FredM67/PVRouter-3-phase/schematics/Readme.md

This directory contains schematics of 3-phase router circuits.
