FredM67/PVRouter-3-phase/3-phases/README.md

# Mk2PVRouter

My version of the 3-phase Mk2PVRouter firmware (see <http://www.mk2pvrouter.co.uk>)

Robin Emley already proposes a 3 phase PV-router (<https://www.mk2pvrouter.co.uk/3-phase-version.html>).
It supports 3 resistive output loads, which are completely independent.

## Implementation documentation

You can start reading the documentation here [3-phase diverter](https://fredm67.github.io/Mk2PVRouter/html/index.html).

## End-user documentation

### Overview

Goal was to modify/optimize the sketch for the "special" case of a 3-phase water heater. A 3-phase water heater is composed in fact of 3 independent heating elements. Most of the time, such a heater can be connected in mono, or 3-phase WYE or 3-phase Delta.
When connected in WYE (without varistor), there's no need of a neutral wire because the system is equally distributed, so at any time, there's no current flowing to the neutral.

If a diverter is used, the neutral wire must be connected.

Added functionalities:

- load priorities management (configurable)
- off-peak period detection (configurable)
- force full power
- temperature sensor (just reading for the moment)
- optimized (RF) data logging
- serial output in JSON or TXT

The original sketch had to be completely re-worked and re-structured to support temperature reading. In the original sketch, the ISR "just" reads and converts the analog data, and the processing is done in the loop. This won't work with a temperature sensor because of its slow performance. It would break the whole system, current/voltage data will be lost, ...

Now, all the time-critical processing is done inside the ISR, other stuff like (RF) data logging, Serial printing, temperature reading is made inside the loop(). The ISR and main processor communicate with each other through "events".

### Load priorities management

In my variant of Robin's sketch, the 3 loads are still physically independent, so it means, the router will divert surplus of energy to the first load (highest priority) from 0% to 100%, then to the second (0% to 100%) and finally to the third.

To avoid that the priorities stays all the time unchanged, which would mean that load 1 will run much more than load 2, which again will run much more than 3, I've added a priority management.
Each day, the load priorities are rotated, so over many days, all the heating elements will run somehow the same amount of time.

### Off-peak period detection

Depending on the country, some energy meters provide a switch which toggles on at the beginning of the off-peak period. It is intended to control a relay. If you wire it to a free digital pin of the router (in my case D3), you can detect off-peak/peak period.

### Force full power

Support has been added to force full power on specific loads. Each load can be forced independantly from each other, start time and duration can be set individualy.

In my variant, that's used to switch the heater one during off-peak period if not enough surplus has been routed during the day. Here, to optimize the behavior, a temp-sensor will be used to check the temperature of the water and decide to switch on or not during night.

### Temperature sensor

For the moment, just reading. It'll be used to optimize force full power, to make the right decision during night.

### Wiring diagram

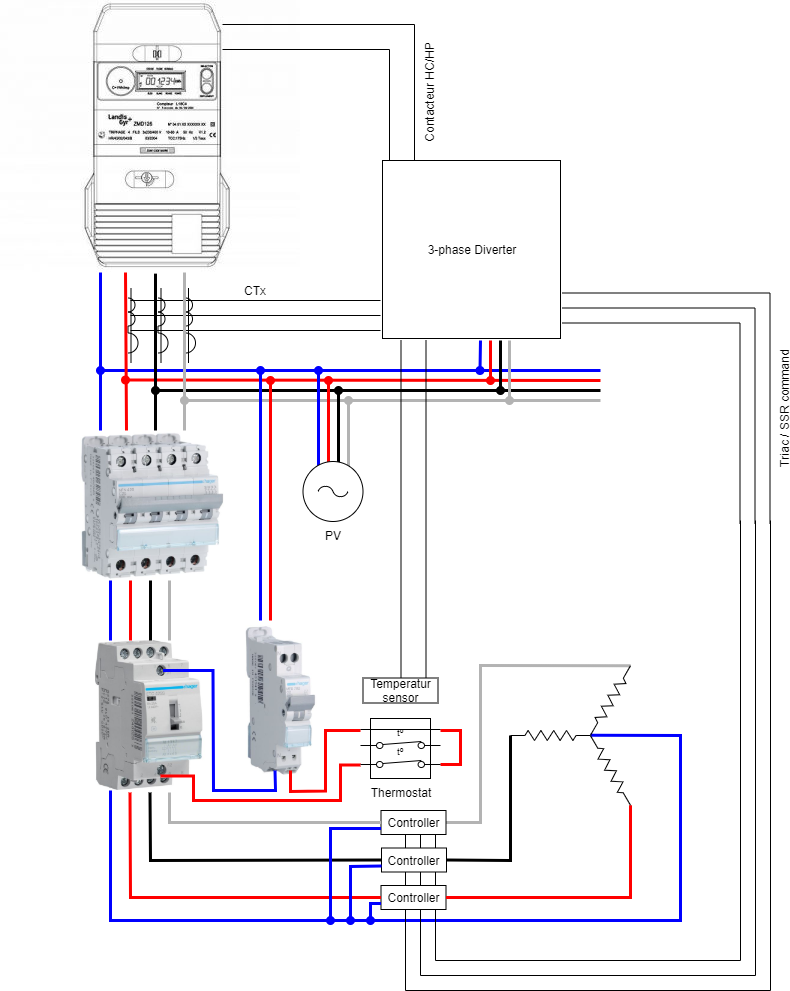
[picture p9: 3-phases/Chauffe-eau.png]
Chauffe-eau

*Figure: Wiring diagram*

#### About the thermostat

Since on all (3-phase) water heaters I've seen, the thermostat switches only 2 phases in normal mode (all 3 phases in security mode), it must be wired in another way to achieve a full switch on all 3 phases. In a fully balanced 3-phase situation, you don't need any neutral wire. To switch off the device, you only need to switch off 2 phases.

For that, I've "recycled" a peak/off peak 3-phase relay. It doesn't matter on which phase the command coil is connected, but it must be permanent (not through the router).
