FredM67/PVRouter-3-phase/dev/cal_CTx_v_meter/Readme.md

# Mk2PVRouter (calibration)

Calibration sketch for the 3-phase router.
