FredM67/PVRouter-3-phase/lang/en-us/Gallery.md

# Photo Gallery (3-phase version)

A couple of my realizations... other coming...

## 3-phase router with 3 outputs

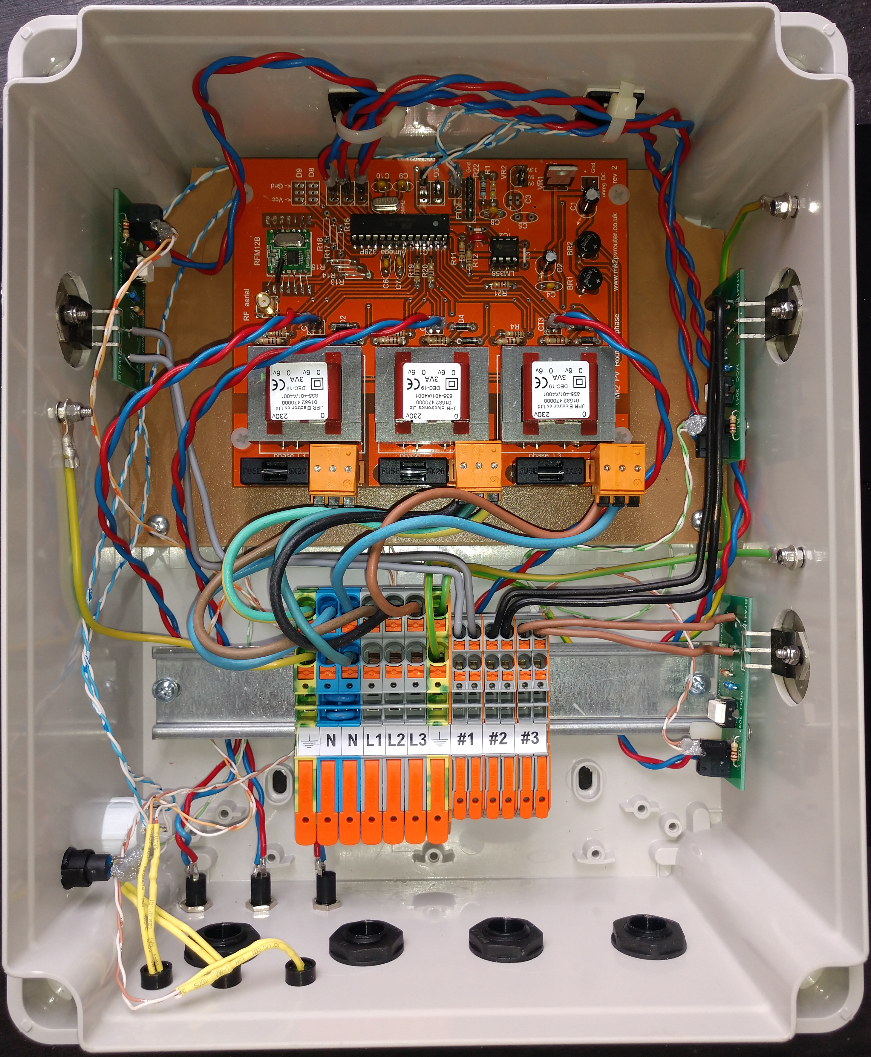
[picture p10: img/f43a4829-44de-41a0-b174-76a6b04aa8e5.jpg]
[](../../img/f43a4829-44de-41a0-b174-76a6b04aa8e5.jpg "Global view")

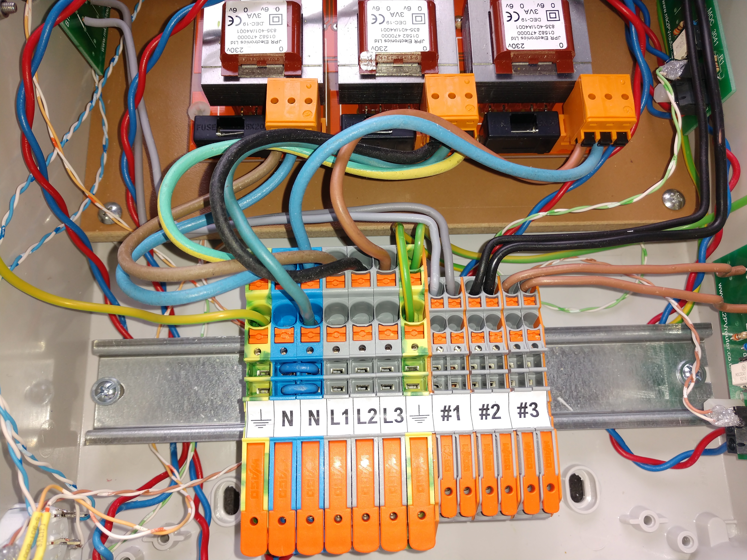
[picture p11: img/15fbcad6-1bfa-4044-9d88-a480483ec13e.jpg]
Rail terminal blocks
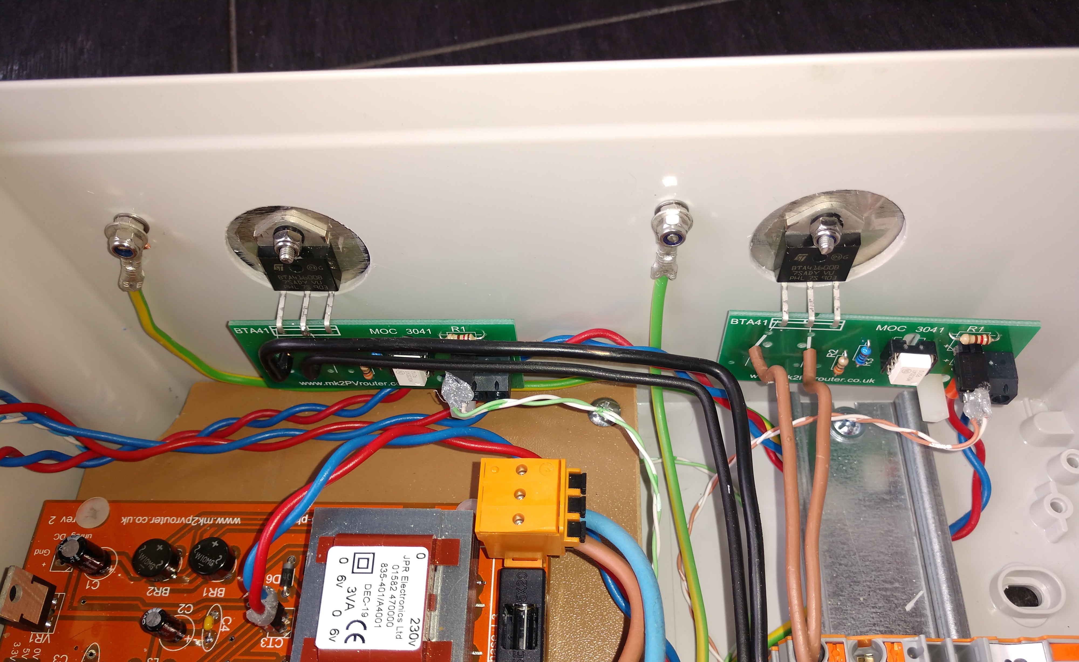
[picture p12: img/5dacd511-de53-4113-8b8e-37a5f743554b.jpg]
Mounted outputs
Detailed view of an output
[](../../img/15fbcad6-1bfa-4044-9d88-a480483ec13e.jpg "Rail terminal blocks") [](../../img/5dacd511-de53-4113-8b8e-37a5f743554b.jpg "Mounted outputs") [](../../img/66680b82-261f-409e-a767-3690944cae35.jpg "Detailed view of an output")

## 3-phase router with 4 outputs

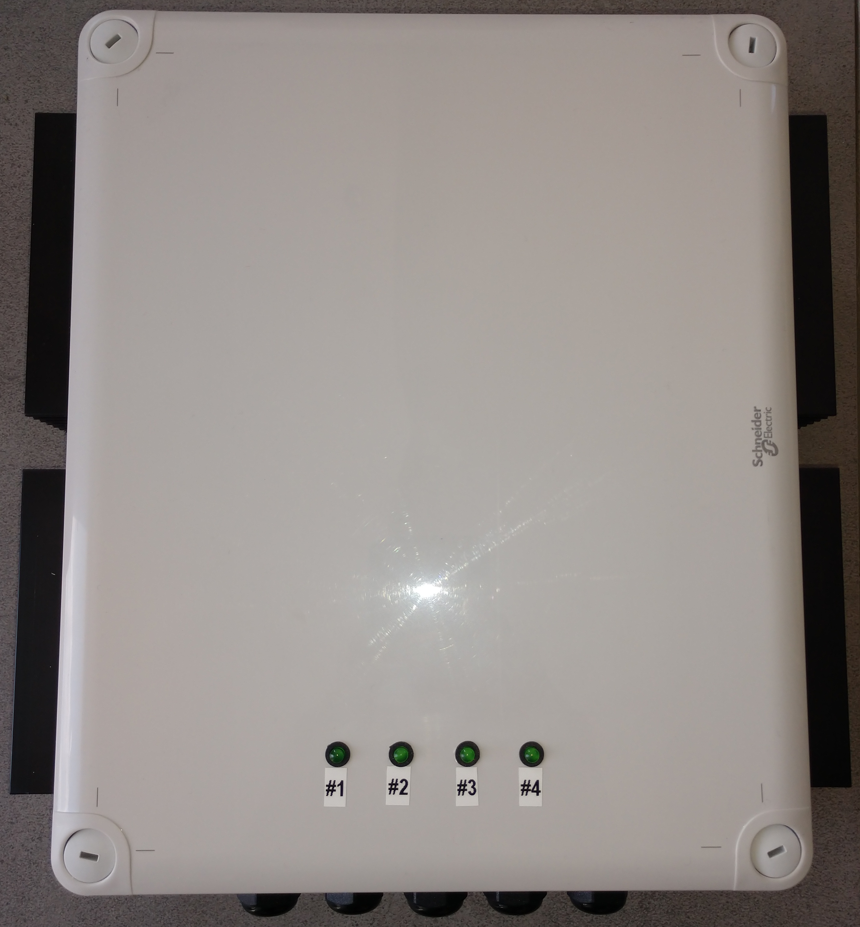
[picture p14: img/f05c2b09-0ed7-457f-b3fd-c86048cb763e.jpg]
[](../../img/f05c2b09-0ed7-457f-b3fd-c86048cb763e.jpg "Global view")

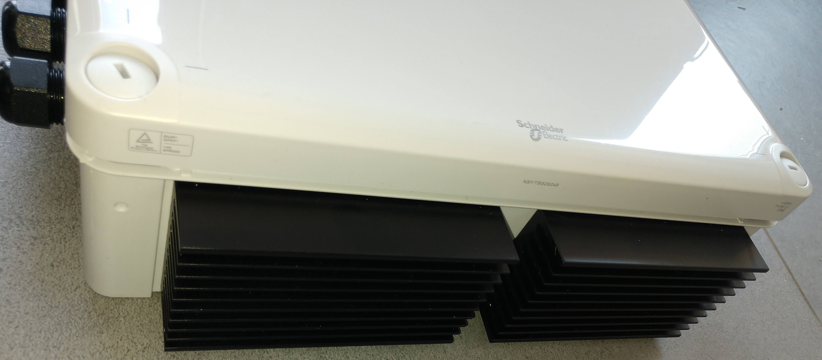
[picture p15: img/ada72e61-2f97-41ee-8d40-62b1563c619a.jpg]
Heatsinks
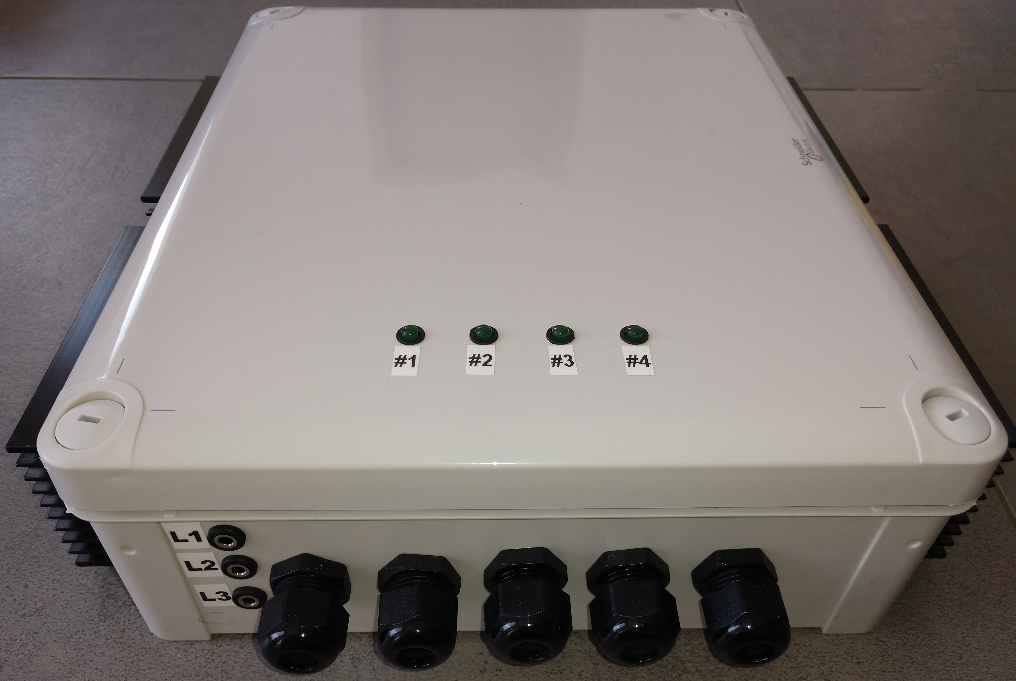
[picture p16: img/897cdbe2-732a-4d81-9d10-05e575900748.jpg]
External connections
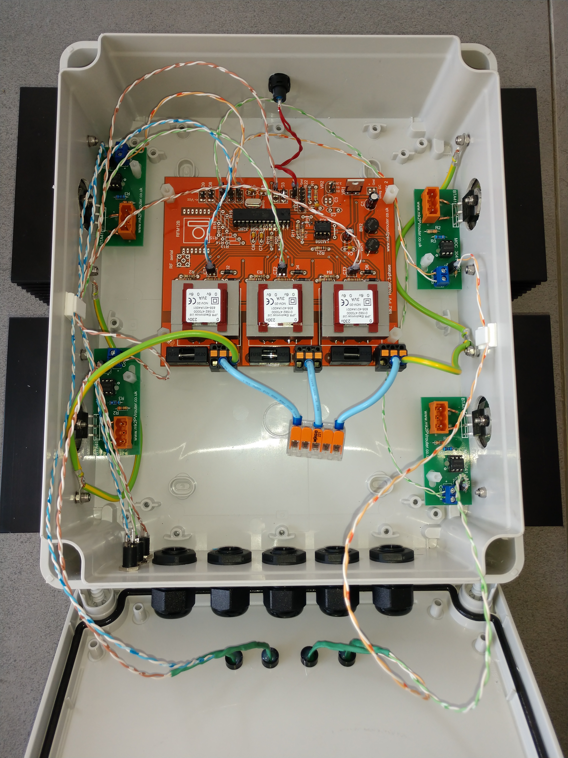
[picture p17: img/8c1568f4-78a3-4125-9e14-d849fb266f01.jpg]
[](../../img/ada72e61-2f97-41ee-8d40-62b1563c619a.jpg "Heatsinks") [](../../img/897cdbe2-732a-4d81-9d10-05e575900748.jpg "External connections") [](../../img/8c1568f4-78a3-4125-9e14-d849fb266f01.jpg "Inside the enclosure")

## 3-phase router, 4 remote cable-wired outputs (optionally 6), all outputs wired through network-cable, split box

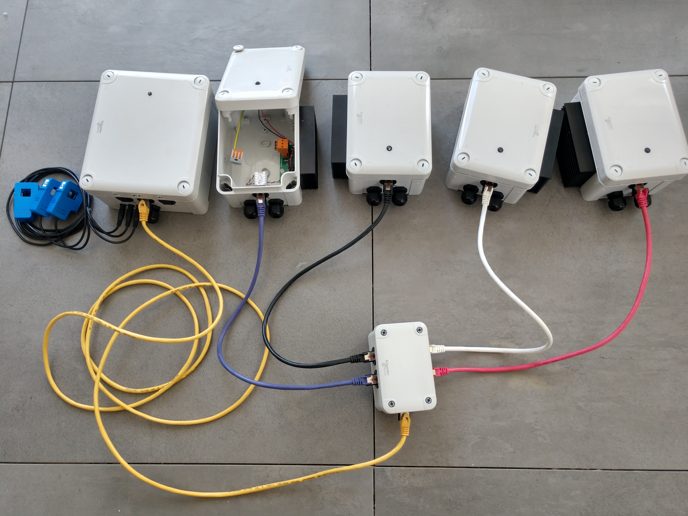
[picture p18: img/d03d563a-dc9d-4a5e-b4b6-94b93cb05c39.jpg]
[](../../img/d03d563a-dc9d-4a5e-b4b6-94b93cb05c39.jpg "Global view")

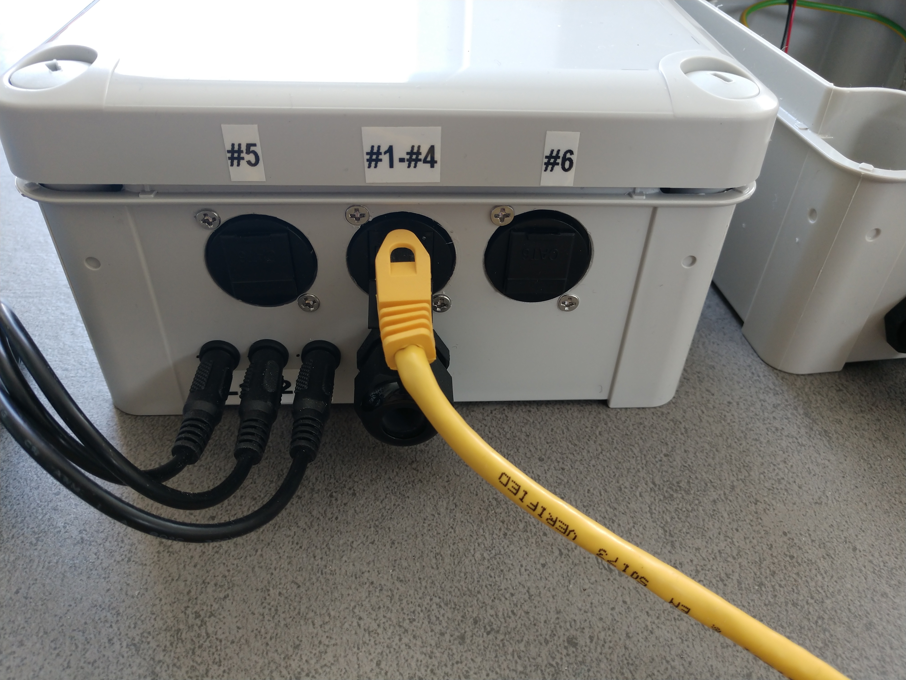
[picture p19: img/d395ef4b-2886-42bc-bf0d-46881865aba8.jpg]
In/Outputs on the main enclosure
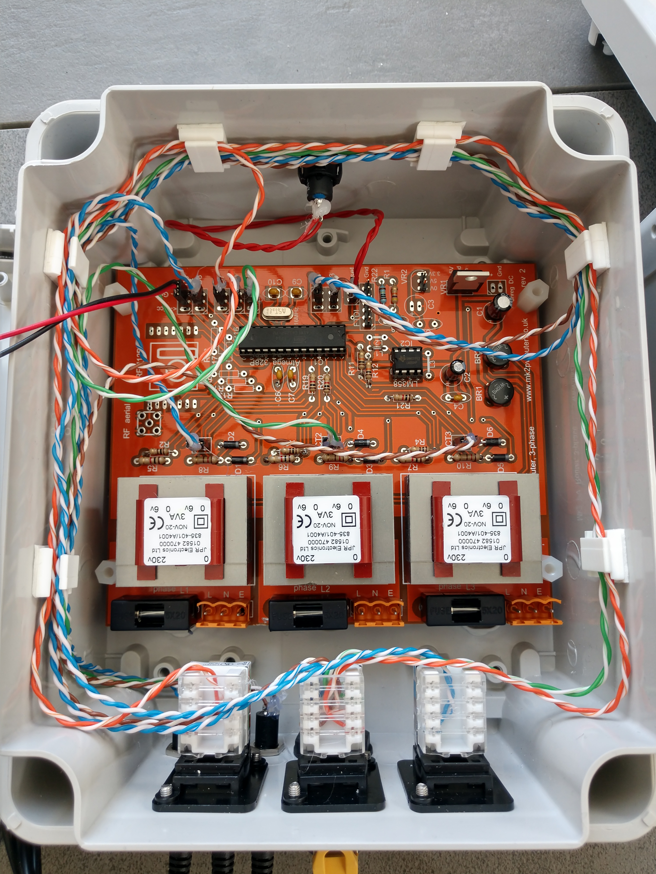
[picture p20: img/b5a37129-8ef5-4b52-9db6-86991e1d2f7e.jpg]
Inside the main enclosure
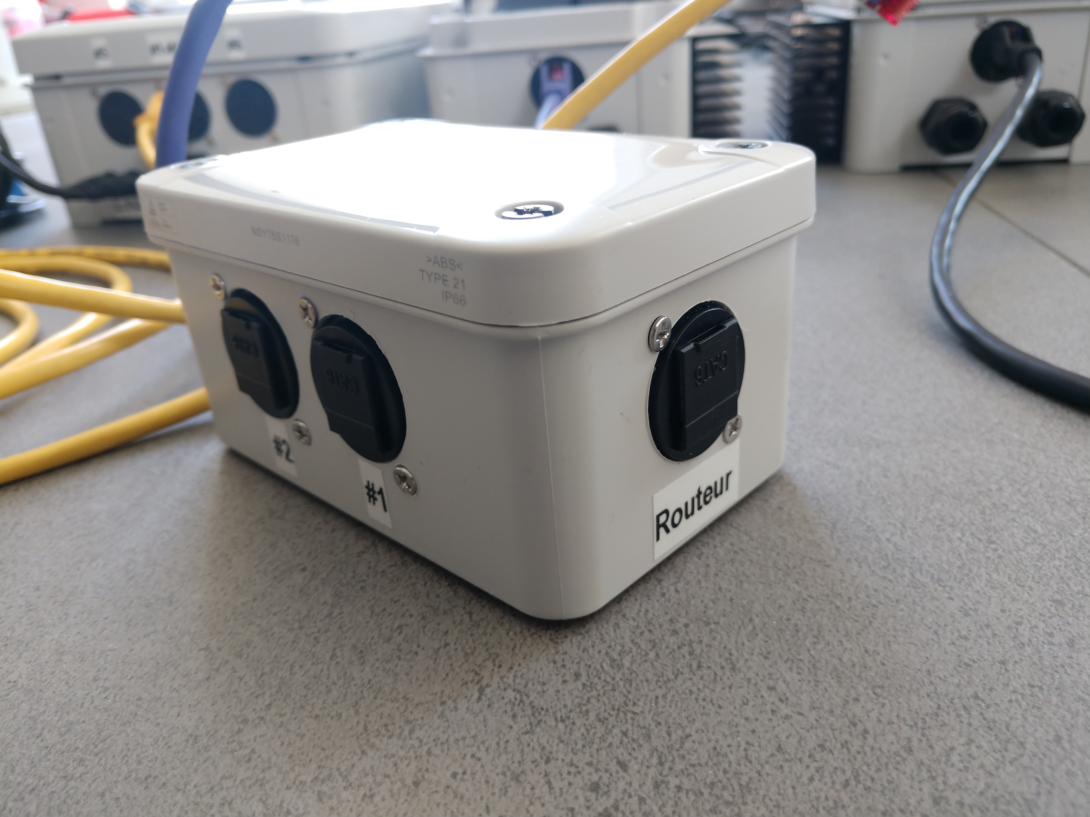
[picture p21: img/3e970a16-3d55-4a36-852a-2b2628096997.jpg]
The split box
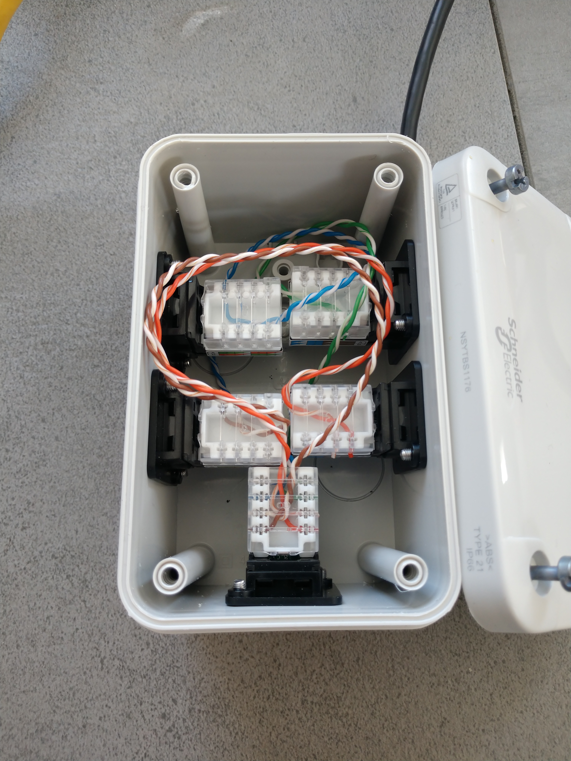
[picture p22: img/4e9bc2a4-d0be-4040-9475-e14ed643a81f.jpg]
Inside the split box
[](../../img/d395ef4b-2886-42bc-bf0d-46881865aba8.jpg "In/Outputs on the main enclosure") [](../../img/b5a37129-8ef5-4b52-9db6-86991e1d2f7e.jpg "Inside the main enclosure") [](../../img/3e970a16-3d55-4a36-852a-2b2628096997.jpg "The split box") [](../../img/4e9bc2a4-d0be-4040-9475-e14ed643a81f.jpg "Inside the split box")

## 3-phase router, 3 outputs, 2 of them can be controlled via Internet (ON/OFF and forcing)

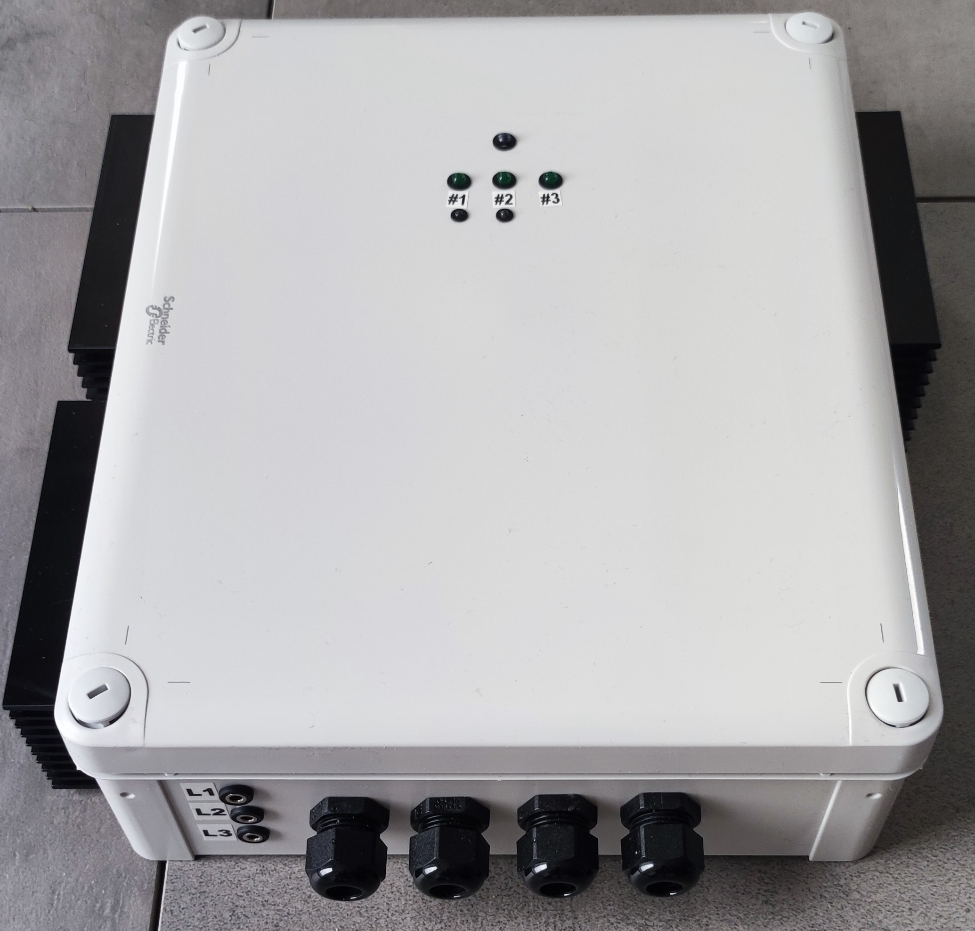
[picture p23: img/ef52c81c-a295-45f7-bca3-10eb83e562a4.jpg]
[](../../img/ef52c81c-a295-45f7-bca3-10eb83e562a4.jpg "Global view")

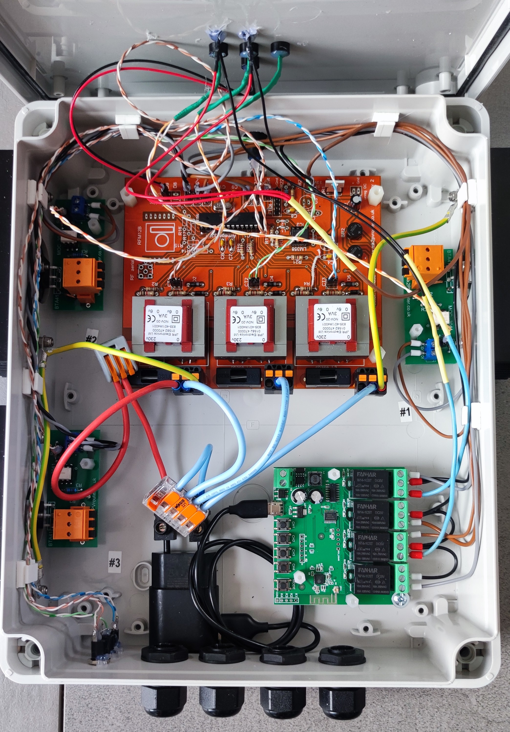
[picture p24: img/087771a1-7ec3-4b7a-a278-35999f6821ce.jpg]
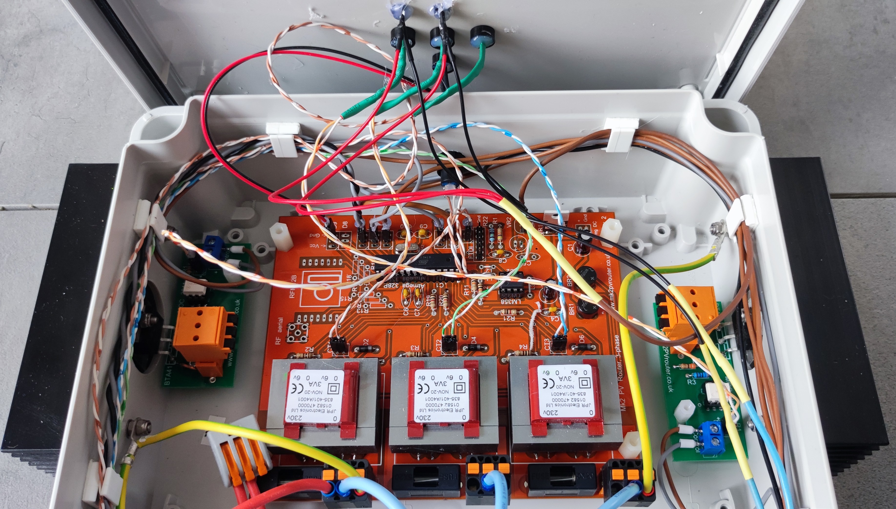
[picture p25: img/85be2be7-bddf-4039-a8d4-92ca197cbb45.jpg]
Router side
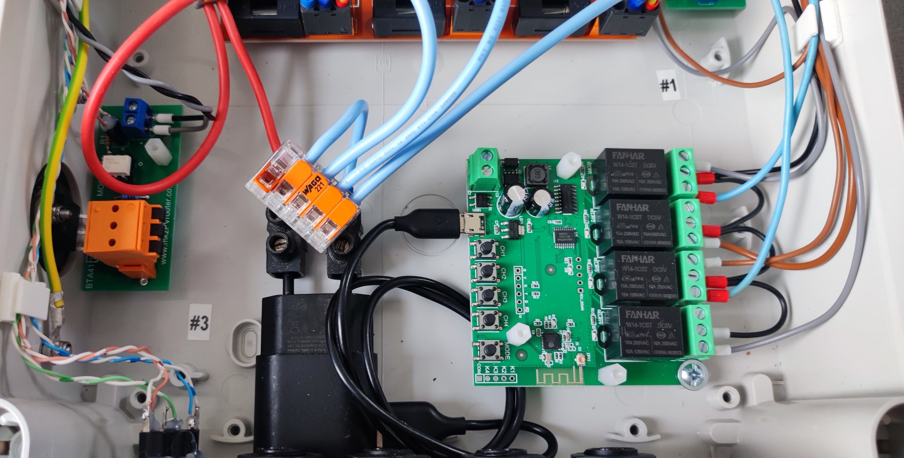
[picture p26: img/819f9d70-4cc6-4b29-9f21-2e0b1ef3fdeb.jpg]
Smart-Relay side
[](../../img/087771a1-7ec3-4b7a-a278-35999f6821ce.jpg "Inside the enclosure") [](../../img/85be2be7-bddf-4039-a8d4-92ca197cbb45.jpg "Router side") [](../../img/819f9d70-4cc6-4b29-9f21-2e0b1ef3fdeb.jpg "Smart-Relay side")

## 3-phase router, 6 outputs, all can be controlled via Internet (forcing and priority inversion)

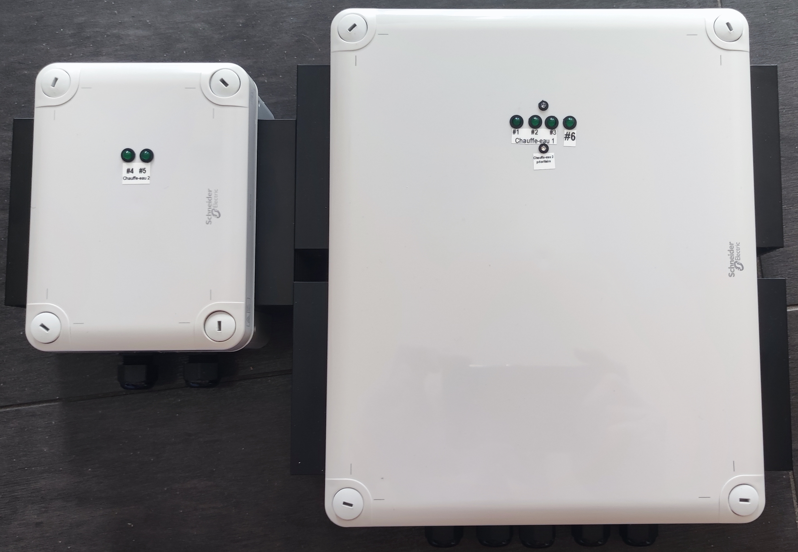
[picture p27: img/67a14e30-d1ed-40c5-9e4e-aacd2ed93499.jpg]
[](../../img/67a14e30-d1ed-40c5-9e4e-aacd2ed93499.jpg "Global view")

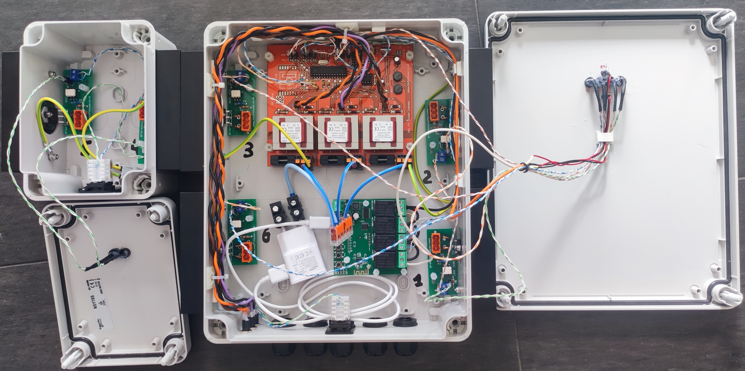
[picture p28: img/fec8f37e-e799-4abc-9041-8d9bfd7e70b1.jpg]
[](../../img/fec8f37e-e799-4abc-9041-8d9bfd7e70b1.jpg "Inside the enclosure")

## 3-phase router, 8 outputs, controlled as pair (1-5, 2-6, 3-7, 4-8), group overwrite (1-2-3, 4, 5-6-7, 8)

[Vue d'ensemble](../../img/e3771671-75ca-476e-a3ef-71582be48c67.jpg "Global view top")
[Vue d'ensemble](../../img/0f794432-89e2-4ba1-b937-163a495122d8.jpg "Global view connections")

[Inside the mainboard enclosure](../../img/6cbcf9fc-bbc0-4d99-a64a-3eaab45e34d8.jpg "Inside the mainboard enclosure") [Inside the slave enclosure](../../img/e903ec0d-7f42-4b21-998d-019408e88f20.jpg "Inside the slave enclosure") [Mainboard](../../img/20a99fa9-3dcc-4d16-a75c-3266c4db29ac.jpg "Mainboard") [Overwrite switches](../../img/aec80e39-caa6-495b-b781-55cd9dc704b2.jpg "Overwrite switches")
