FredM67/PVRouter-3-phase/docs/Carte-mère.pdf

# Alimentation du routeur triphasé

## Le routeur DOIT être installé de telle façon que les dissipateurs soient à droite et à gauche. (verticaux)

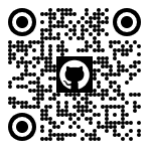
[picture p29: figure]

Selon l'arrivage et disponibilité, les borniers peuvent être différents (couleur, à vis, push-in, ...)

## Routeur - carte-mère

## N L1 L2 L3

L1 | L2 | L3

Il n'est pas strictement nécessaire d'alimenter le routeur via un disjoncteur tétrapolaire, étant donné que chaque entrée est déjà protégée par un fusible de 100mA.
Cependant, il est quand-même conseillé d'utiliser un disjoncteur/sectionneur tétrapolaire dédié.
Il fera aussi office d'interrupteur pour éteindre le routeur pendant une période d'absence par exemple.

## Installation des pinces

Les pinces doivent être installées entre le compteur/disjoncteur principal et l'arrivée principale dans le tableau.

Il y a une flèche gravée sur chaque pince. Cette flèche doit être dans le sens compteur VERS tableau.

Il faut respecter le marquage. La pince L1, doit être connectée à la prise jack L1.

La phase qui passe par la pince L1 doit être la même que celle qui est connectée à la borne L1 de l'alimentation du routeur. Idem pour L2 et L3.
Si nécessaire, contrôler au multimètre (position V~) :

tension entre phases différentes => env. 400V
tension sur la même phase => 0V.

Les borniers à vis, si présents, doivent être contrôlés au bout de quelques jours mais aussi régulièrement.
Au besoin resserrer les bornes. (sans forcer non plus)

L1
L2
L3
1 | 2 | 3
