FredM67/PVRouter-3-phase/README.md

<div align = center>


&nbsp; &nbsp;

<br/>
Stand With Ukraine (https://stand-with-ukraine.pp.ua)
</div>

<p align="center">
  <span>Français</span> |
  <a href="lang/en-us/">English</a>
</p>

# PVRouter (version triphasée)

Ma version du firmware Mk2PVRouter en 3 phases (voir http://www.mk2pvrouter.co.uk).

Robin Emley propose déjà un routeur PV triphasé (https://www.mk2pvrouter.co.uk/3-phase-version.html). Il prend en charge 3 charges de sortie résistives, qui sont complètement indépendantes.

---
**_NOTE:_** Pour une version en monophasé, voir [PVRouter-Single](https://github.com/FredM67/PVRouter-Single).

---

- [PVRouter (version triphasée)](#pvrouter-version-triphasée)
  - [Gallerie photo](#gallerie-photo)
  - [Schéma de la carte-mère](#schéma-de-la-carte-mère)
  - [Documentation de développement](#documentation-de-développement)
  - [Documentation de l’utilisateur final](#documentation-de-lutilisateur-final)
    - [Aperçu](#aperçu)
    - [Gestion des priorités de charge](#gestion-des-priorités-de-charge)
    - [Détection HC](#détection-hc)
    - [Forçage pleine puissance](#forçage-pleine-puissance)
    - [Capteur de température](#capteur-de-température)
    - [Profil Enphase zéro export](#profil-enphase-zéro-export)
- [Comment câbler le routeur](#comment-câbler-le-routeur)
- [Applications / Diagrammes de câblage](#applications--diagrammes-de-câblage)
  - [Pré-requis](#pré-requis)
  - [Chauffe-eau avec thermostat mécanique](#chauffe-eau-avec-thermostat-mécanique)
    - [Passage du monophasé au triphasé (avec neutre)](#passage-du-monophasé-au-triphasé-avec-neutre)
    - [Câblage](#câblage)
  - [Chauffe-eau avec thermostat ACI monophasé](#chauffe-eau-avec-thermostat-aci-monophasé)
  - [Chauffe-eau avec thermostat ACI triphasé (SANS neutre)](#chauffe-eau-avec-thermostat-aci-triphasé-sans-neutre)
  - [Alternatives SANS neutre](#alternatives-sans-neutre)
    - [Chauffe-eau avec thermostat mécanique](#chauffe-eau-avec-thermostat-mécanique-1)

## Gallerie photo

Vous trouverez quelques [photos](Gallery.md) de routeurs assemblés.

## Schéma de la carte-mère

Vous trouverez [ici](schematics/3phase_Mainboard.pdf) le schéma de la carte-mère.

## Documentation de développement

Vous pouvez commencer à lire la documentation ici [3-phase diverter](https://fredm67.github.io/PVRouter-3-phase/) (en anglais).

## Documentation de l’utilisateur final

### Aperçu

L’objectif était de modifier/optimiser le programme pour le cas « spécial » d’un chauffe-eau triphasé. Un chauffe-eau triphasé est composé en fait de 3 éléments de chauffage indépendants. La plupart du temps, un tel chauffe-eau peut être connecté en monophasé, en triphasé étoile (WYE) ou triphasé triangle (Delta). Lorsqu’il est connecté en étoile (sans varistor), il n’y a pas besoin de fil de neutre parce que le système est équilibré, donc à tout moment, il n’y a pas de courant qui circule vers le neutre.

Fonctionnalités ajoutées :

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

### Gestion des priorités de charge

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

### Détection HC

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

### Forçage pleine puissance

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

### Capteur de température

Pour l’instant, uniquement lecture. Il sera utilisé pour optimiser la pleine puissance de la force, pour prendre la bonne décision pendant la nuit.

### Profil Enphase zéro export

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

Comme effet secondaire, le diverteur ne verra pas à aucun moment un surplus d’énergie.  
L’idée est donc d’appliquer un certain décalage à l’énergie mesurée par le diverteur.
Comme il est déjà commenté dans le code, après l'assignation d’une valeur négative à *REQUIRED_EXPORT_IN_WATTS*, le diverter agira comme un générateur PV.  
Si vous définissez une valeur de *-20*, chaque fois que le diverter mesure le flux d’énergie, il ajoutera *-20* aux mesures.  

Alors, maintenant voyons ce qui se passe dans différents cas:

- la valeur mesurée est **positive** (importation d’énergie = pas d’excédent), après avoir ajouté *-20*, cela reste positif, le diverter ne fait rien. Pour une valeur comprise entre -20 et 0, le déviateur ne fera rien non plus.
- la valeur mesurée est **autour de zéro**. Dans cette situation, la limitation du "profil zéro exportation" est active.  
Après l’ajout de *-20*, nous obtenons une valeur négative, ce qui déclenchera le détournement d’énergie vers le chauffe-eau.  
Ensuite, il y a une sorte de réaction en chaîne. L’Envoy détecte plus de consommation, décide d’augmenter la production.  
À la mesure suivante, le diverter mesure à nouveau une valeur autour de zéro, ajoute à nouveau -20, et détourne encore plus d’énergie.  
Lorsque la production (et l’excédent) arrive au maximum possible, la valeur mesurée restera autour de zéro+ et le système deviendra stable.

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

# Applications / Diagrammes de câblage

Je veux:

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

## Pré-requis

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

---
**_Avertissement de sécurité_**

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

---

## Chauffe-eau avec thermostat mécanique

### Passage du monophasé au triphasé (avec neutre)

---
**_Nécessite un routeur avec 3 sorties_**

Avec cette solution, vous commandez chaque résistance séparément l'une de l'autre.

---

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

### Câblage

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

---
**_Rappel_**

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

---

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

Chauffe-eau avec thermostat mécanique  
*Figure: Diagramme de câblage*

## Chauffe-eau avec thermostat ACI monophasé

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

Chauffe-eau avec thermostat ACI monophasé  
*Figure : Diagramme de câblage*

## Chauffe-eau avec thermostat ACI triphasé (SANS neutre)

---
**_Nécessite un routeur avec 2 sorties_**

Avec cette solution, vous commandez chaque résistance séparément l'une de l'autre.

---

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

La carte ACI doit être reliée à 3 phases permanentes.

Chauffe-eau avec thermostat ACI triphasé  
*Figure : Diagramme de câblage*

## Alternatives SANS neutre

---
**_Nécessite un routeur avec 2 sorties_**

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

---

### Chauffe-eau avec thermostat mécanique

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

---
**_Zoom sur le thermostat_**

Il faut bien faire attention, en regardant sur le thermostat, quelles bornes sont coupées.

En **rouge**, coupure de sécurité (remarquez le 'S' sur chaque contact) : les 3 phases sont coupées.

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

Thermostat mécanique  
*Figure: Exemple de thermostat*

---

Chauffe-eau avec thermostat mécanique  
*Figure: Diagramme de câblage*
