FredM67/PVRouter-3-phase/Gallery.md

<h1>Galerie photo (version triphasée)</h1>

Quelques une de mes réalisations... d'autres à venir...

- [Routeur triphasé 3 sorties](#routeur-triphasé-3-sorties)
- [Routeur triphasé 4 sorties multi-boîtier (carte-mère, 3 sorties, 1 sortie)](#routeur-triphasé-4-sorties-multi-boîtier-carte-mère-3-sorties-1-sortie)
  - [Boîtier carte-mère](#boîtier-carte-mère)
  - [Boîtier 3 sorties à proximité du chauffe-eau](#boîtier-3-sorties-à-proximité-du-chauffe-eau)
  - [Boîtier 1 sortie déporté](#boîtier-1-sortie-déporté)
- [Routeur triphasé 4 sorties](#routeur-triphasé-4-sorties)
- [Routeur triphasé, 4 sorties distantes par câble (en option 6), sorties connectées par câble réseau, boîte de répartition](#routeur-triphasé-4-sorties-distantes-par-câble-en-option-6-sorties-connectées-par-câble-réseau-boîte-de-répartition)
- [Routeur triphasé, 3 sorties, dont 2 pilotables via Internet (ON/OFF et marche forcée)](#routeur-triphasé-3-sorties-dont-2-pilotables-via-internet-onoff-et-marche-forcée)
- [Routeur triphasé, 6 sorties, toutes pilotables via Internet (marche forcée et inversion de priorité)](#routeur-triphasé-6-sorties-toutes-pilotables-via-internet-marche-forcée-et-inversion-de-priorité)
- [Routeur triphasé, 8 sorties, pilotées par paire (1-5, 2-6, 3-7, 4-8), marche forcée par groupe (1-2-3, 4, 5-6-7, 8)](#routeur-triphasé-8-sorties-pilotées-par-paire-1-5-2-6-3-7-4-8-marche-forcée-par-groupe-1-2-3-4-5-6-7-8)
- [Routeur triphasé, 8 sorties, sorties 4 et 5 pilotées ensemble, 4 groupes de marche forcée (1-2-3, 4, 5, 6-7-8)](#routeur-triphasé-8-sorties-sorties-4-et-5-pilotées-ensemble-4-groupes-de-marche-forcée-1-2-3-4-5-6-7-8)

## Routeur triphasé 3 sorties

<p align="center">
Vue d'ensemble
<br>
Connecteurs sur rail
Montage des platines de sortie
Zoom sur une platine de sortie
</P>

## Routeur triphasé 4 sorties multi-boîtier (carte-mère, 3 sorties, 1 sortie)

### Boîtier carte-mère
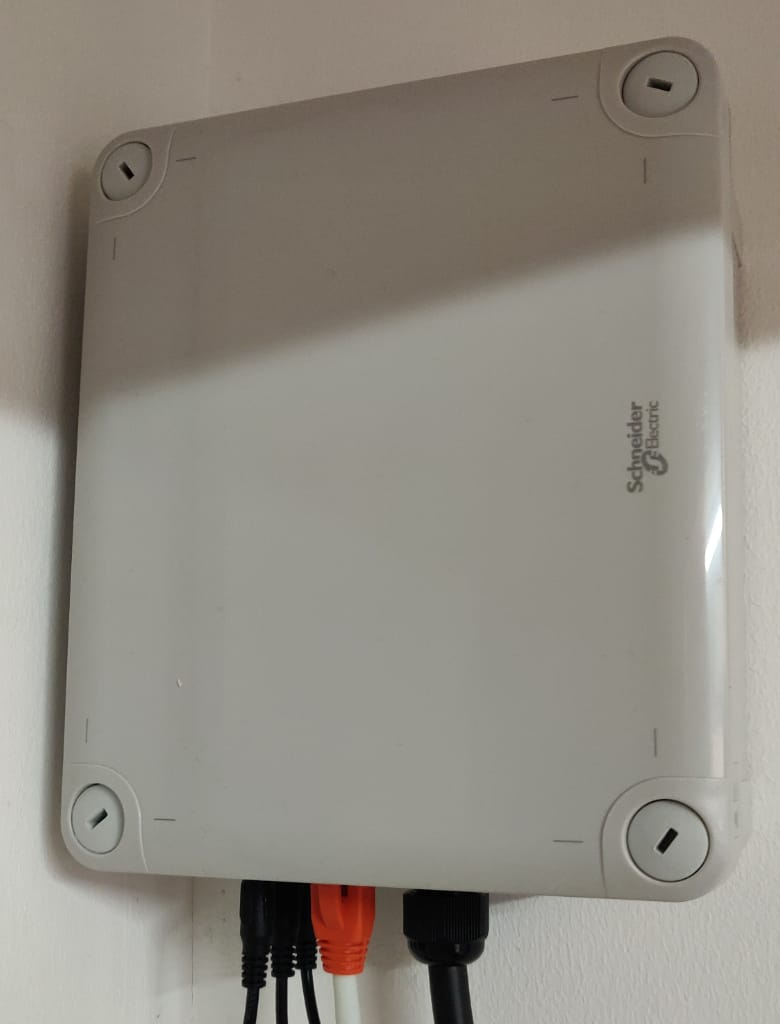
[picture p30: img/ce87c606-ab8e-44c3-b274-a3130b65f113.jpg]
Boîtier carte-mère
[](img/ce87c606-ab8e-44c3-b274-a3130b65f113.jpg "Boîtier carte-mère")
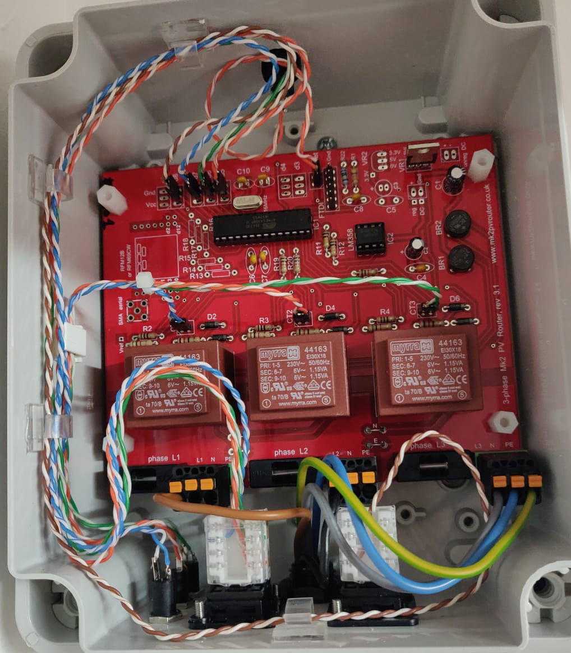
[picture p31: img/ad63052d-ebe5-4e1f-9275-3632a48a1255.jpg]
[](img/ad63052d-ebe5-4e1f-9275-3632a48a1255.jpg "Intérieur")

### Boîtier 3 sorties à proximité du chauffe-eau
Ce boîtier contient les 3 sorties mais aussi une horloge et un contacteur pour la marche forcée programmée.
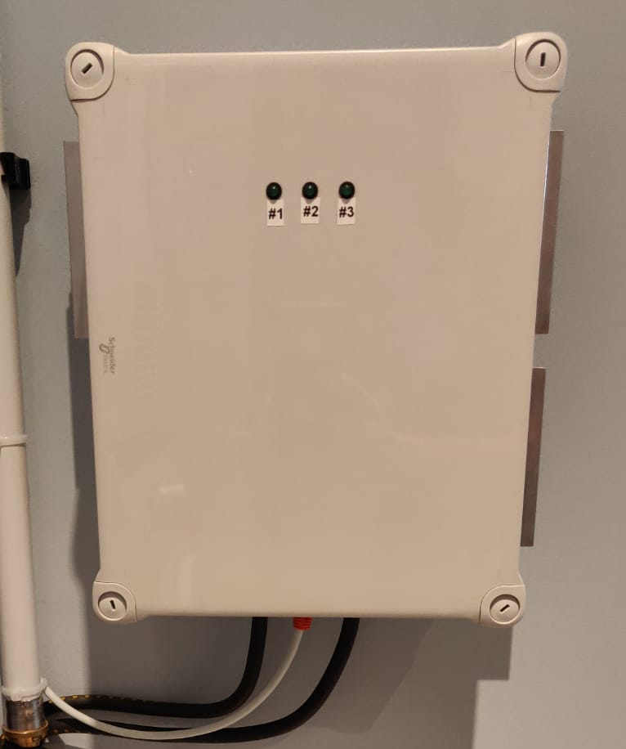
[picture p32: img/5291760f-7a21-42bc-bc12-00a551be847b.jpg]
Boîtier chauffe-eau
[](img/5291760f-7a21-42bc-bc12-00a551be847b.jpg "Boîtier chauffe-eau")

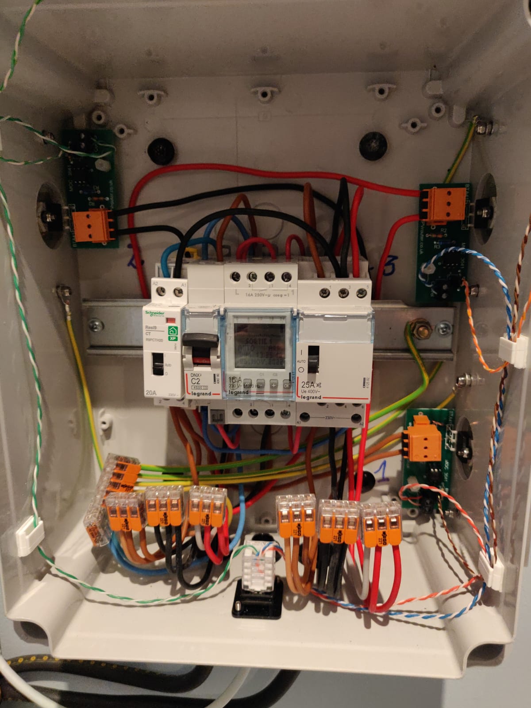
[picture p33: img/071abcd1-ac9d-46c5-bbe8-30d14bfc3ad4.jpg]
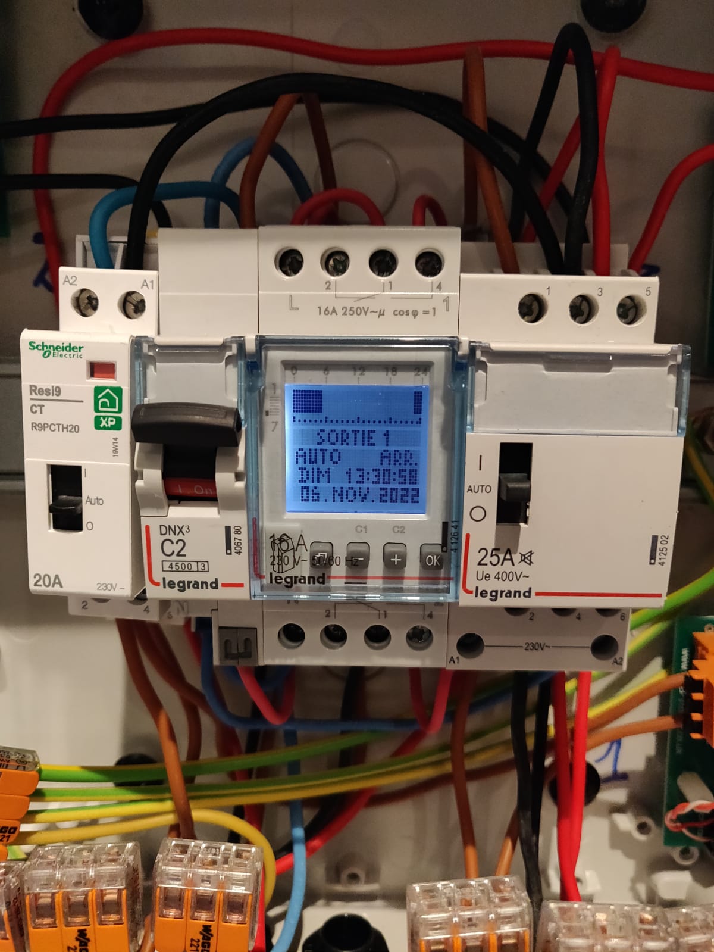
[picture p34: img/f40a586f-e764-486c-9dc7-2c0aa3767f4b.jpg]
Détail horloge/contacteur
[](img/071abcd1-ac9d-46c5-bbe8-30d14bfc3ad4.jpg "Intérieur") [](img/f40a586f-e764-486c-9dc7-2c0aa3767f4b.jpg "Détail horloge/contacteur")

### Boîtier 1 sortie déporté
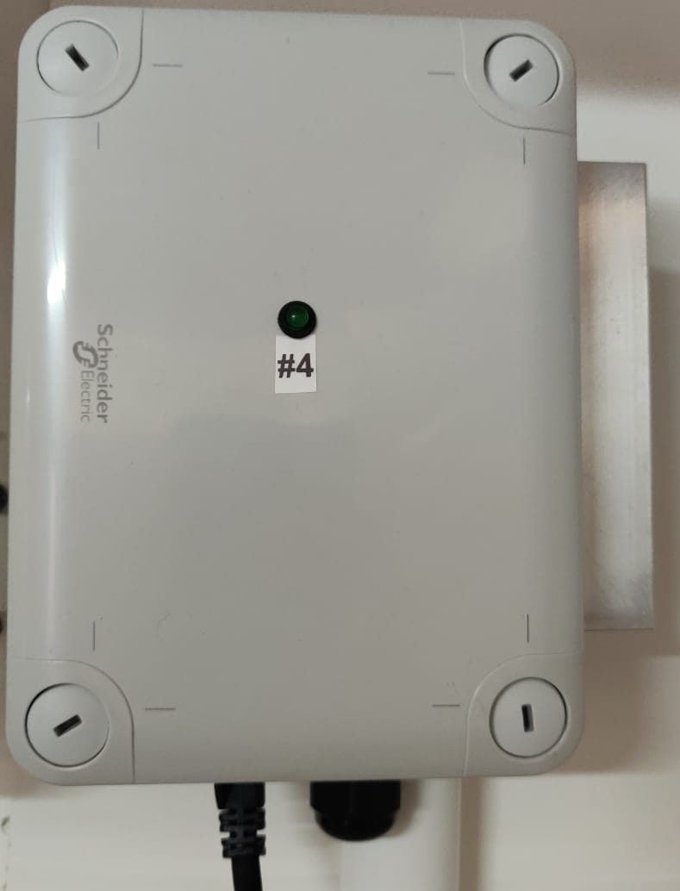
[picture p35: img/ed17d132-fba7-4b36-9564-83fd12fedd17.jpg]
Boîtier 1 sortie
[](img/ed17d132-fba7-4b36-9564-83fd12fedd17.jpg "Boîtier 1 sortie")

## Routeur triphasé 4 sorties

[Vue d'ensemble](img/f05c2b09-0ed7-457f-b3fd-c86048cb763e.jpg "Vue d'ensemble")

[Radiateurs](img/ada72e61-2f97-41ee-8d40-62b1563c619a.jpg "Radiateurs") [Connections extérieures](img/897cdbe2-732a-4d81-9d10-05e575900748.jpg "Connections extérieures") [Intérieur du boîtier](img/8c1568f4-78a3-4125-9e14-d849fb266f01.jpg "Intérieur du boîtier")

## Routeur triphasé, 4 sorties distantes par câble (en option 6), sorties connectées par câble réseau, boîte de répartition

[Vue d'ensemble](img/d03d563a-dc9d-4a5e-b4b6-94b93cb05c39.jpg "Global view")

[Entrées/sorties sur boîtier principal](img/d395ef4b-2886-42bc-bf0d-46881865aba8.jpg "Entrées/sorties sur boîtier principal") [Intérieur du boîtier principal](img/b5a37129-8ef5-4b52-9db6-86991e1d2f7e.jpg "Intérieur du boîtier principal") [La boîte de répartition](img/3e970a16-3d55-4a36-852a-2b2628096997.jpg "La boîte de répartition") [Intérieur de la boîte de répartition](img/4e9bc2a4-d0be-4040-9475-e14ed643a81f.jpg "Intérieur de la boîte de répartition")

## Routeur triphasé, 3 sorties, dont 2 pilotables via Internet (ON/OFF et marche forcée)

[Vue d'ensemble](img/ef52c81c-a295-45f7-bca3-10eb83e562a4.jpg "Vue d'ensemble")

[Intérieur du boîtier](img/087771a1-7ec3-4b7a-a278-35999f6821ce.jpg "Intérieur du boîtier") [Partie routeur](img/85be2be7-bddf-4039-a8d4-92ca197cbb45.jpg "Partie routeur") [Partie Smart-Relay](img/819f9d70-4cc6-4b29-9f21-2e0b1ef3fdeb.jpg "Partie Smart-Relay")

## Routeur triphasé, 6 sorties, toutes pilotables via Internet (marche forcée et inversion de priorité)

[Vue d'ensemble](img/67a14e30-d1ed-40c5-9e4e-aacd2ed93499.jpg "Vue d'ensemble") [Intérieur du boîtier](img/fec8f37e-e799-4abc-9041-8d9bfd7e70b1.jpg "Intérieur du boîtier")

## Routeur triphasé, 8 sorties, pilotées par paire (1-5, 2-6, 3-7, 4-8), marche forcée par groupe (1-2-3, 4, 5-6-7, 8)

| [Vue d'ensemble](img/e3771671-75ca-476e-a3ef-71582be48c67.jpg "Vue d'ensemble dessus") |  [Vue d'ensemble](img/0f794432-89e2-4ba1-b937-163a495122d8.jpg "Vue d'ensemble connectique") |

| [Intérieur du boîtier routeur](img/6cbcf9fc-bbc0-4d99-a64a-3eaab45e34d8.jpg "Intérieur du boîtier routeur") | [Intérieur du boîtier esclave](img/e903ec0d-7f42-4b21-998d-019408e88f20.jpg "Intérieur du boîtier esclave") |
[Partie routeur](img/20a99fa9-3dcc-4d16-a75c-3266c4db29ac.jpg "Partie routeur") | [Commandes de marche forcée](img/aec80e39-caa6-495b-b781-55cd9dc704b2.jpg "Commandes de marche forcée") |

## Routeur triphasé, 8 sorties, sorties 4 et 5 pilotées ensemble, 4 groupes de marche forcée (1-2-3, 4, 5, 6-7-8)
Ce routeur effectue également la rotation des priorités des charges 1, 2 et 3 toutes les 24h.

| [Vue d'ensemble](img/1351dc21-54c0-4e20-94f3-659b4994def6.jpg "Vue d'ensemble ouvert") | [Vue d'ensemble](img/25c3ebe7-431e-49c9-8f38-0967fc986766.jpg "Vue d'ensemble connectique") |

[Intérieur du boîtier routeur](img/02f0d946-e2fa-45ba-a237-af305bf2e19e.jpg "Intérieur du boîtier routeur")

| [Commandes de marche forcée](img/93b6093b-e6ae-40bb-8223-56eb6bcaded0.jpg "Commandes de marche forcée") | [Zoom carte-mère](img/c5745e45-afac-4638-8403-28f54c4dd6d3.jpg "Zoom carte-mère") |
