FredM67/PVRouter-3-phase/analysis/ewma/TEMA_ANALYSIS_README.md

# Analyse de l'Efficacité EMA/DEMA/TEMA

 

---

Ce répertoire contient des scripts Python qui analysent et comparent différentes implémentations de moyennes mobiles exponentielles utilisées dans le projet PV Router.

## 📈 Résultats d'Analyse

### Comparaison Complète des Filtres

Comparaison EMA, DEMA, TEMA

**Observations clés :**
- **TEMA Multi-Alpha** (bleu plein) : Équilibre optimal entre réactivité et stabilité
- **TEMA Standard** (bleu pointillé) : Plus conservateur, convergence plus lente
- **EMA Simple** (orange) : Rapide mais bruyant, mauvaise immunité aux nuages

### Analyse du Contrôle des Relais

Analyse de Commutation des Relais

**Métriques de performance :**
- **TEMA Multi-α** : Commutation minimale des relais, excellente stabilité
- **TEMA Standard** : Bonnes performances, légèrement plus de commutations
- **EMA Simple** : Commutation excessive lors d'événements nuageux

### Comparaison des Implémentations TEMA

Comparaison des Implémentations TEMA

**Comparaison directe** montrant comment TEMA multi-alpha offre une immunité aux nuages supérieure tout en maintenant la réactivité.

## 📊 Scripts Disponibles

### 1. Analyse Complète
```bash
python3 ema_effectiveness_analysis.py
```

**Génère :**
- `ema_dema_tema_comparison.png` - Comparaison complète des filtres sur plusieurs scénarios
- `filter_performance_analysis.png` - Métriques de performance et temps d'établissement
- `relay_switching_analysis.png` - Efficacité du contrôle des relais pour les applications PV

**Ce qu'il analyse :**
- **TEMA Multi-Alpha** (votre implémentation de production)
- **TEMA Standard** (formule single-alpha officielle)
- **EMA Simple** ligne de base
- Réponse à l'échelon, immunité aux nuages, rejet du bruit
- Fréquence de commutation des relais lors d'événements nuageux

### 2. Comparaison de Développement
```bash
cd dev/EWMA_CloudImmunity_Benchmark
python3 tema_comparison.py
```

**Génère :**
- `tema_implementation_comparison.png` - Comparaison ciblée des implémentations TEMA

## 🔍 Principales Découvertes

### Pourquoi TEMA Multi-Alpha est Supérieur

**Votre Implémentation de Production :**
```cpp
ema = ema_raw >> round_up_to_power_of_2(A);           // Lissage de base
ema_ema = ema_ema_raw >> (round_up_to_power_of_2(A) - 1);     // 2x plus rapide  
ema_ema_ema = ema_ema_ema_raw >> (round_up_to_power_of_2(A) - 2); // 4x plus rapide
return 3 * (ema - ema_ema) + ema_ema_ema;            // Formule TEMA
```

**Implémentation Standard :**
```cpp
// Tous les niveaux utilisent le même alpha - moins optimal
ema = ema_raw >> round_up_to_power_of_2(A);
ema_ema = ema_ema_raw >> round_up_to_power_of_2(A);   // Même alpha !
ema_ema_ema = ema_ema_ema_raw >> round_up_to_power_of_2(A); // Même alpha !
```

### Comparaison des Performances

| Métrique | TEMA Multi-α | TEMA Standard | EMA Simple |
|---|---|---|---|
| **Immunité aux Nuages** | ✅ Excellente | 🟡 Bonne | ❌ Pauvre |
| **Réactivité** | ✅ Rapide | 🟡 Modérée | ✅ Rapide |
| **Stabilité des Relais** | ✅ Très Stable | 🟡 Stable | ❌ Instable |
| **Réponse à l'Échelon** | ✅ Optimale | 🟡 Plus Lente | ✅ Rapide mais bruyante |

### Détail des Valeurs Alpha

Pour A=24 (délai de 2 minutes) :
- **EMA** : α = 1/16 (base stable)
- **EMA_EMA** : α = 1/8 (2x plus rapide - suit les changements moyens)  
- **EMA_EMA_EMA** : α = 1/4 (4x plus rapide - capture les tendances court terme)

Cela crée un **équilibre parfait** :
- Stabilité long terme grâce à l'EMA lent
- Suivi des tendances moyen terme grâce à l'EMA_EMA 2x
- Réactivité court terme grâce à l'EMA_EMA_EMA 4x
- La formule TEMA combine intelligemment les trois

## 🎯 Avantages Pratiques pour le Routeur PV

1. **Meilleure Immunité aux Nuages** : Ignore les ombres nuageuses brèves tout en répondant aux vrais changements
2. **Moins de Commutations de Relais** : Fonctionnement plus stable, moins d'usure des contacts de relais
3. **Temps de Réponse Optimal** : Assez rapide pour les changements de charge, assez lent pour la stabilité
4. **Réduction des Perturbations Réseau** : Flux de puissance plus lisse vers le réseau

## 📈 Comment Lire les Graphiques

### Graphique de Comparaison Principal
- **Lignes pleines** : Implémentation multi-alpha (production)
- **Lignes pointillées** : Implémentation standard  
- **Lignes pointées** : Ligne de base EMA simple
- **Ligne bleue épaisse** : TEMA Multi-α (recommandé pour le contrôle des relais)

### Analyse des Performances
- **Réponse à l'Échelon** : Montre la rapidité d'atteinte des valeurs cibles par les filtres
- **Immunité aux Nuages** : Teste la réponse aux chutes de puissance brèves
- **Visualisation Alpha** : Montre les différents niveaux de réactivité
- **Temps d'Établissement** : Temps pour atteindre 95% de la valeur finale

### Analyse de Commutation des Relais  
- **Courbes de puissance** : Comment les différents filtres répondent aux événements nuageux
- **États des relais** : Comportement ON/OFF pour chaque type de filtre
- **Nombre de commutations** : Nombre d'opérations de relais (plus bas = meilleur)

## 🚀 Conclusion

Votre implémentation TEMA multi-alpha est **supérieure** à l'approche standard car :

1. **Combine plusieurs échelles de temps** - stabilité + réactivité
2. **Optimisée pour les applications solaires** - excellente immunité aux nuages  
3. **Réduit l'usure des relais** - moins d'événements de commutation
4. **Maintient la stabilité du réseau** - transitions de puissance lisses

L'analyse confirme que votre code de production utilise l'approche de filtrage optimale pour le contrôle des relais du routeur PV !

## 📊 Analyse Complète des Résultats

### Analyse de Chronologie Étendue

Comparaison de Filtre Étendue

Cette analyse complète montre le comportement des filtres à travers plusieurs scénarios avec des périodes d'observation étendues pour démontrer la stabilisation :

1. **Réponse à l'Échelon** : Transitions nettes sans dépassement
2. **Événements Nuageux** : Excellente immunité aux chutes de puissance brèves  
3. **Fluctuations** : Fonctionnement stable durant les changements rapides
4. **Rampe Graduelle** : Suivi approprié des changements de puissance lents
5. **Signal Bruité** : Rejet supérieur du bruit tout en suivant les tendances

### Performance du Contrôle des Relais

Analyse de Relais Étendue

L'analyse du contrôle des relais démontre :
- **Commutation minimale** avec TEMA multi-alpha lors d'événements nuageux
- **Fonctionnement stable** sur des périodes étendues
- **Comportement de seuil optimal** prévenant les oscillations des relais

Ces résultats valident que votre implémentation de production fournit les meilleures performances pour les applications de routeur PV.

## 📋 Prérequis

- Python 3.x
- matplotlib 
- numpy

Les dépendances sont automatiquement installées si manquantes.
