FredM67/PVRouter-3-phase/lang/fr-fr/Gallery.md

La galerie photo française se trouve maintenant dans la [racine](/Gallery.md).
