FredM67/PVRouter-3-phase/docs/CarteACI_tri_HC.pdf

## AVEC contacteur Jour/Nuit et carte ACI triphasée

## ATTENTION

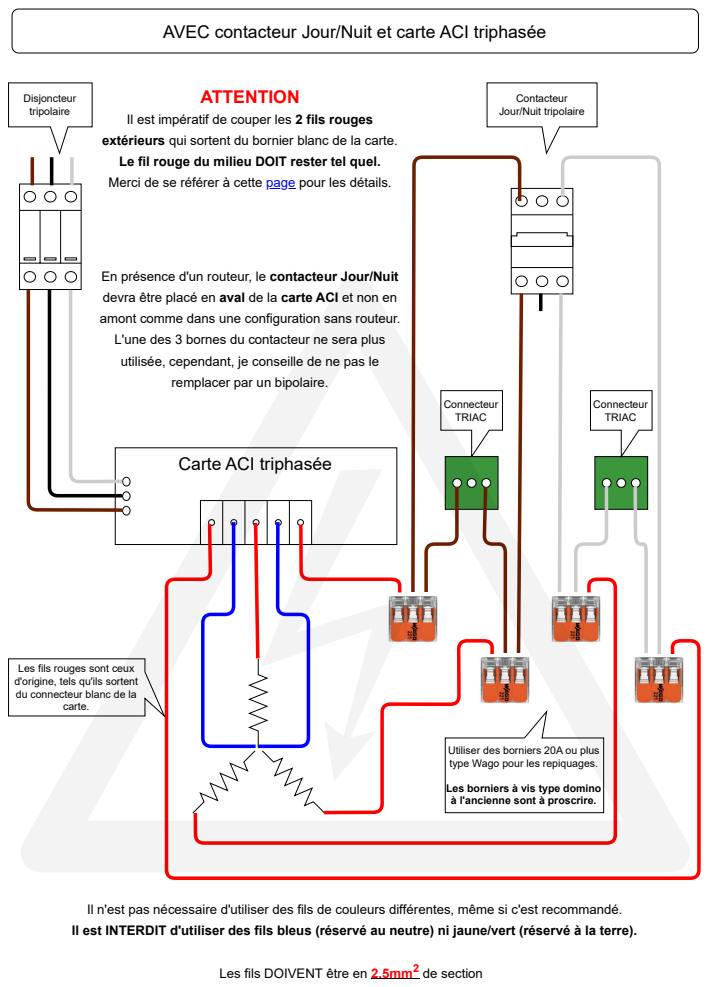
[picture p36: page 1]
Disjoncteur tripolaire; de section; Connecteur TRIAC; carte.

Contacteur
Jour/Nuit tripolaire

Il est impératif de couper les 2 fils rouges
extérieurs qui sortent du bornier blanc de la carte.
Le fil rouge du milieu DOIT rester tel quel.
Merci de se référer à cette page (https://github.com/FredM67/PVRouter-3-phase/wiki/Cartes-ACI-monophas%C3%A9e-et-triphas%C3%A9e) pour les détails.

En présence d'un routeur, le contacteur Jour/Nuit
devra être placé en aval de la carte ACI et non en
amont comme dans une configuration sans routeur.
L'une des 3 bornes du contacteur ne sera plus
utilisée, cependant, je conseille de ne pas le

remplacer par un bipolaire.

Carte ACI triphasée

Les fils rouges sont ceux
d'origine, tels qu'ils sortent
du connecteur blanc de la

Utiliser des borniers 20A ou plus
type Wago pour les repiquages.

Les borniers à vis type domino
à l'ancienne sont à proscrire.

Il n'est pas nécessaire d'utiliser des fils de couleurs différentes, même si c'est recommandé.
Il est INTERDIT d'utiliser des fils bleus (réservé au neutre) ni jaune/vert (réservé à la terre).

Les fils DOIVENT être en 2.5mm²

## AVEC contacteur Jour/Nuit et carte ACI triphasée ET neutre

# AVERTISSEMENT

## Le schéma ci-après présente une faille de sécurité !

## Si le contacteur relié à la carte ACI reste collé, la protection thermique

assurée par la carte ACI n'a plus aucun effet.

La probabilité est certes faible, mais elle existe.

## L'unique solution qui assure le maintien totale de la protection assurée par la carte ACI est l'utilisation d'un routeur qui offre des circuits indépendants pour les sorties (sortie(s) non alimentée(s) par le routeur lui-même)

ET

un câblage selon le schéma précédent, autrement dit SANS neutre.

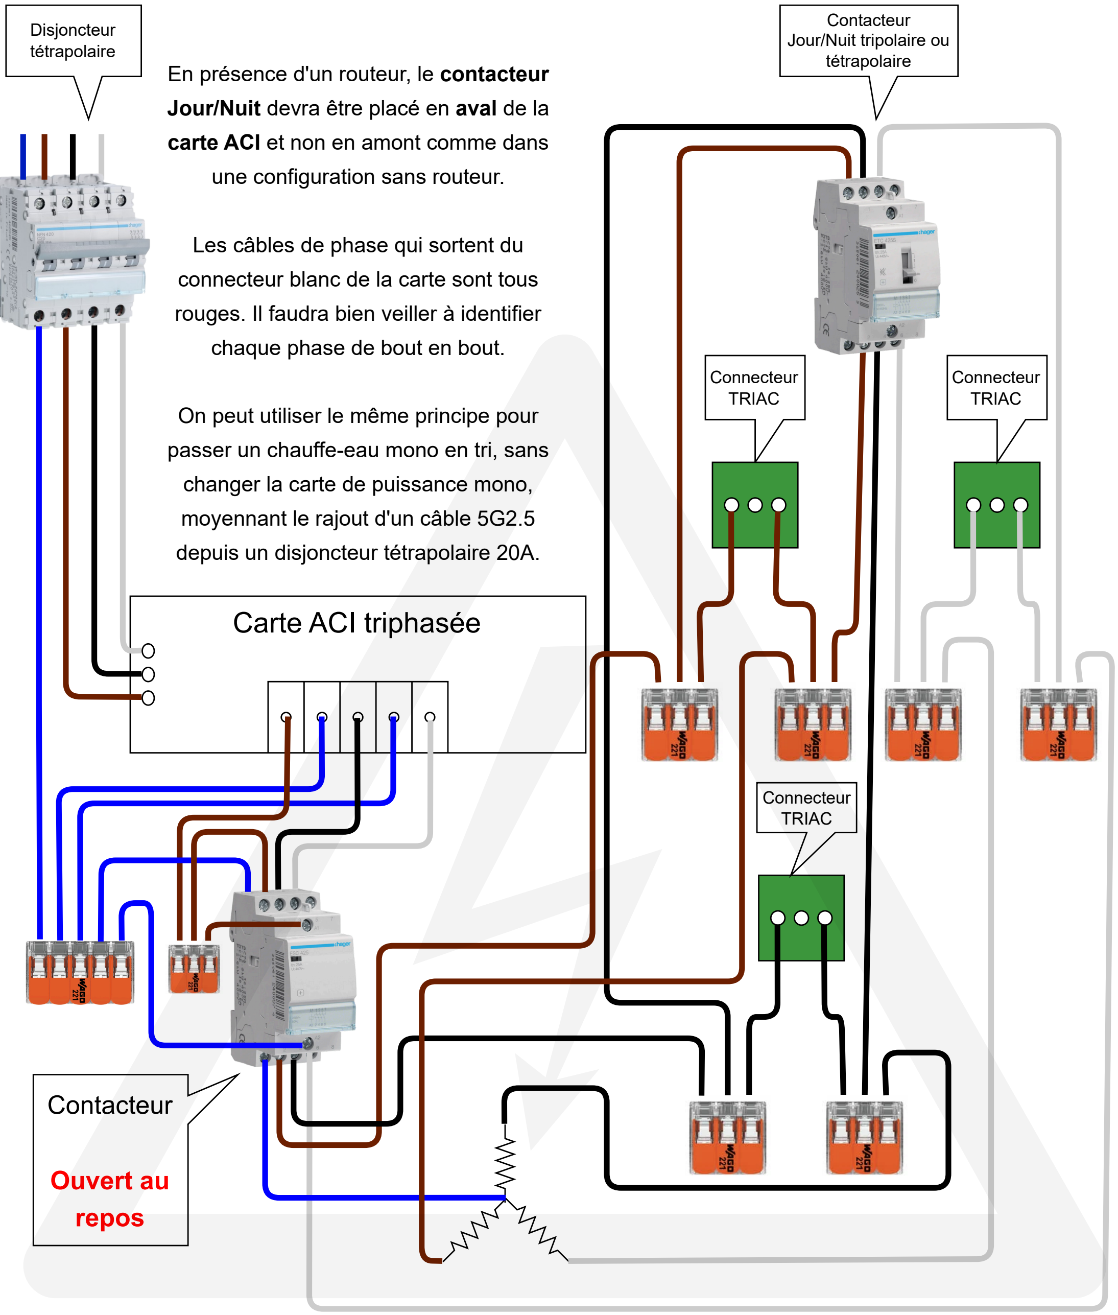
[picture p37: figure]
Disjoncteur tétrapolaire; Connecteur TRIAC; Contacteur Jour/Nuit tripolaire ou tétrapolaire; Carte ACI triphasée; Contacteur; Ouvert au repos; En présence d'un routeur, le contacteur; carte ACI et non en amont comme dans une configuration sans routeur.; Les câbles de phase qui sortent du connecteur blanc de la carte sont tous; chaque phase de bout en bout.; On peut utiliser le même principe pour passer un chauffe-eau mono en tri, sans changer la carte de puissance mono, moyennant le rajout d'un câble 5G2.5 depuis un disjoncteur tétrapolaire 20A.

Les fils DOIVENT être en 2.5mm² de section

Il n'est pas nécessaire d'utiliser des fils de couleurs différentes, même si c'est recommandé. Il est INTERDIT d'utiliser des fils bleus (réservé au neutre) ni jaune/vert (réservé à la terre).

Jour/Nuit devra être placé en aval de la

rouges. Il faudra bien veiller à identifier
