FredM67/PVRouter-3-phase/3-phases/docs/html/group__TimeCritical_ga5a8b9dce34e44a69a46344e8ee1c0dd6_cgraph.png

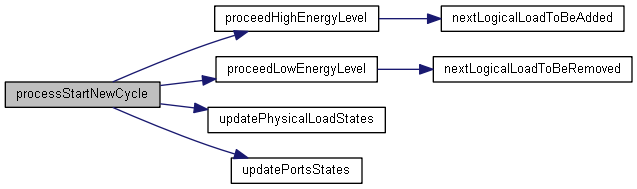
3-phases/docs/html/group__TimeCritical_ga5a8b9dce34e44a69a46344e8ee1c0dd6_cgraph.png
