FredM67/PVRouter-3-phase/3-phases/docs/html/group__TimeCritical_ga7b45c0ceb64e191cb1f053c28f02cee6_cgraph.png

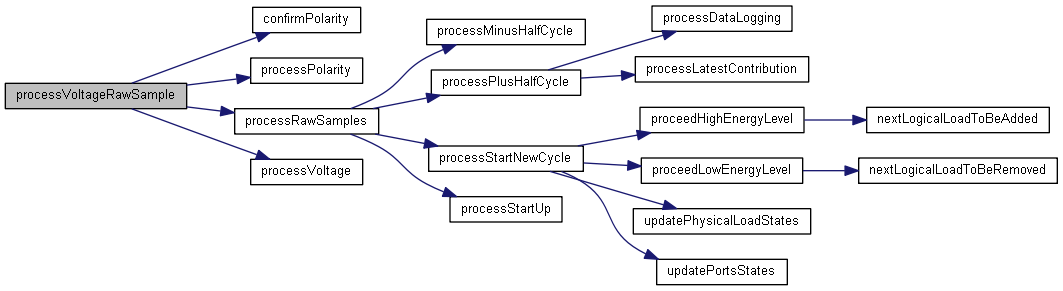
3-phases/docs/html/group__TimeCritical_ga7b45c0ceb64e191cb1f053c28f02cee6_cgraph.png
