FredM67/PVRouter-3-phase/3-phases/docs/html/group__TimeCritical_ga8cff922940989b7edaa8bd0347f9becc_cgraph.png

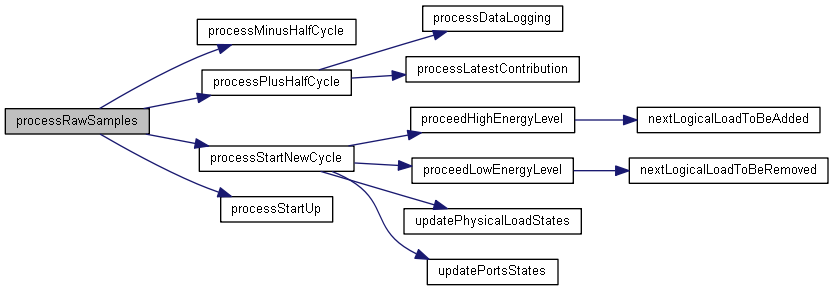
3-phases/docs/html/group__TimeCritical_ga8cff922940989b7edaa8bd0347f9becc_cgraph.png
