FredM67/PVRouter-3-phase/3-phases/docs/html/Mk2__3phase__RFdatalog__temp__1_8ino__incl.png

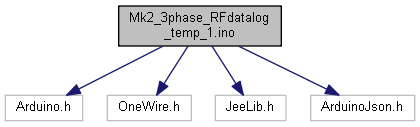
3-phases/docs/html/Mk2__3phase__RFdatalog__temp__1_8ino__incl.png
