FredM67/PVRouter-3-phase/3-phases/docs/html/Mk2__3phase__RFdatalog__temp__1_8ino_a4fc01d736fe50cf5b977f755b675f11d_cgraph.png

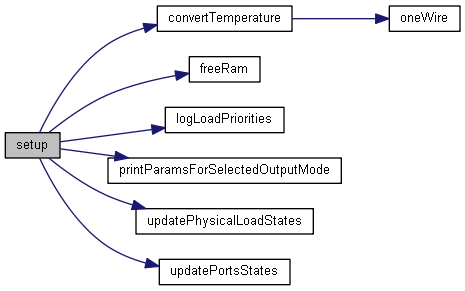
3-phases/docs/html/Mk2__3phase__RFdatalog__temp__1_8ino_a4fc01d736fe50cf5b977f755b675f11d_cgraph.png
