FredM67/PVRouter-3-phase/3-phases/docs/html/Mk2__3phase__RFdatalog__temp__1_8ino_afe461d27b9c48d5921c00d521181f12f_cgraph.png

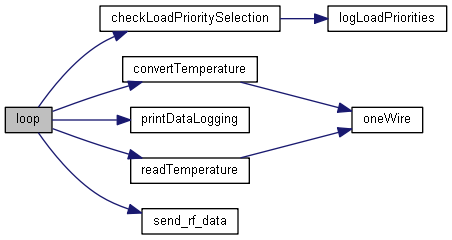
3-phases/docs/html/Mk2__3phase__RFdatalog__temp__1_8ino_afe461d27b9c48d5921c00d521181f12f_cgraph.png
