FredM67/PVRouter-3-phase/analysis/plots/ema_dema_tema_comparison.png

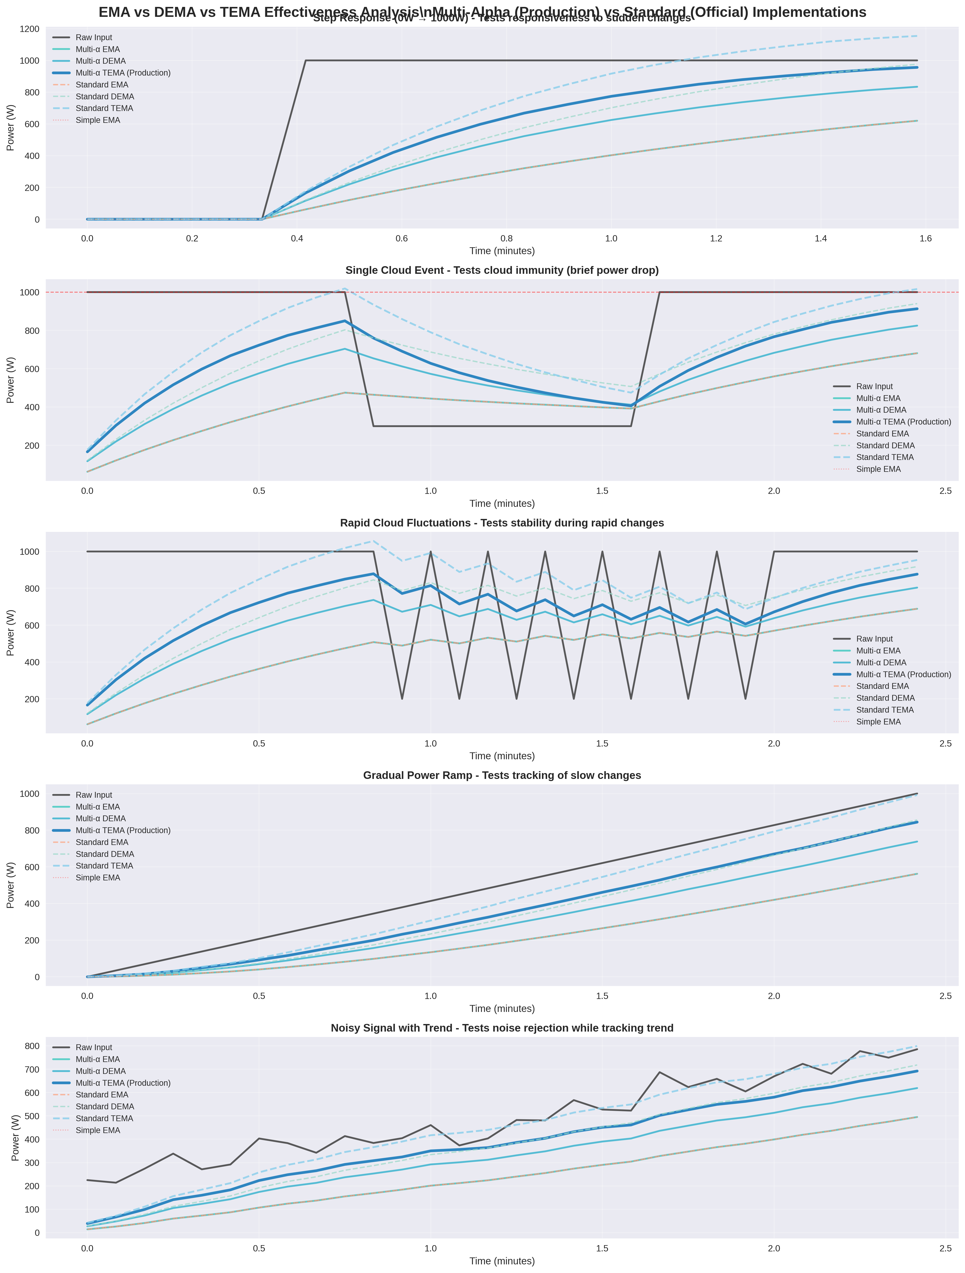
analysis/plots/ema_dema_tema_comparison.png
