FredM67/PVRouter-3-phase/analysis/plots/relay_switching_analysis.png

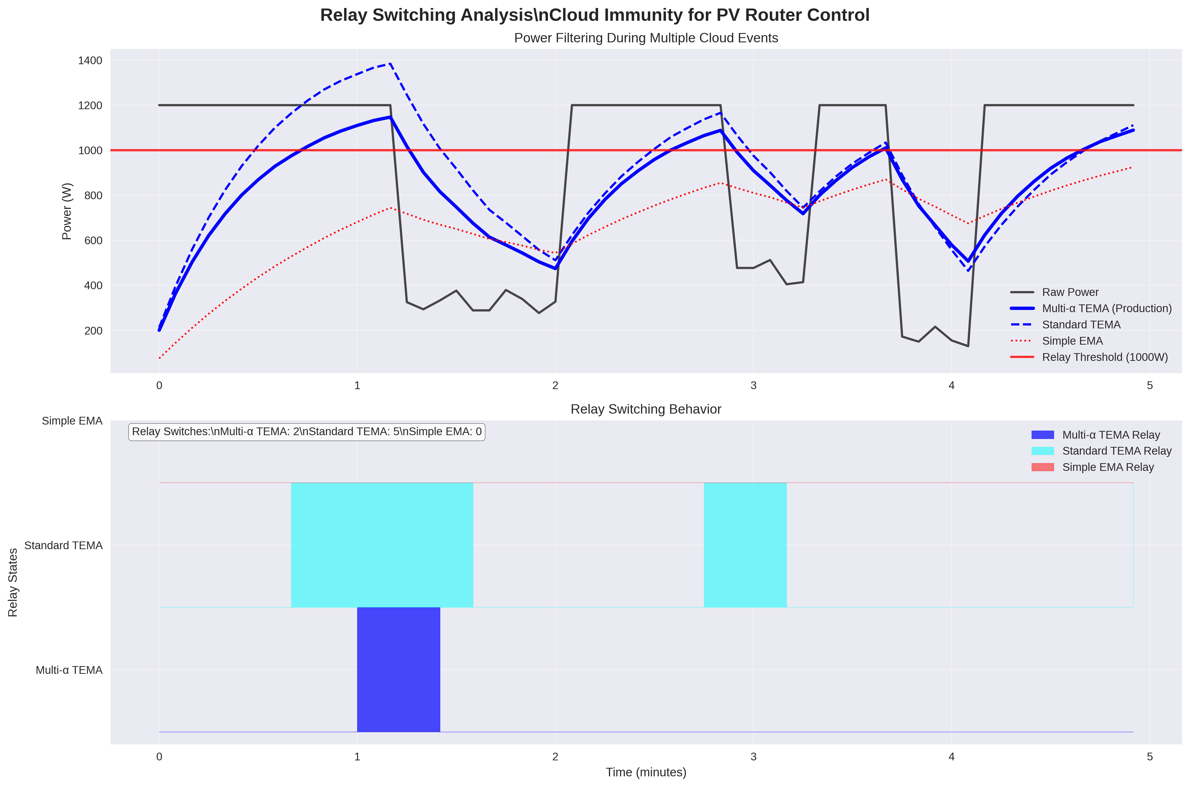
analysis/plots/relay_switching_analysis.png
