FredM67/PVRouter-3-phase/img/45df385b-920a-4481-9a2a-8a5a469650a1.jpg

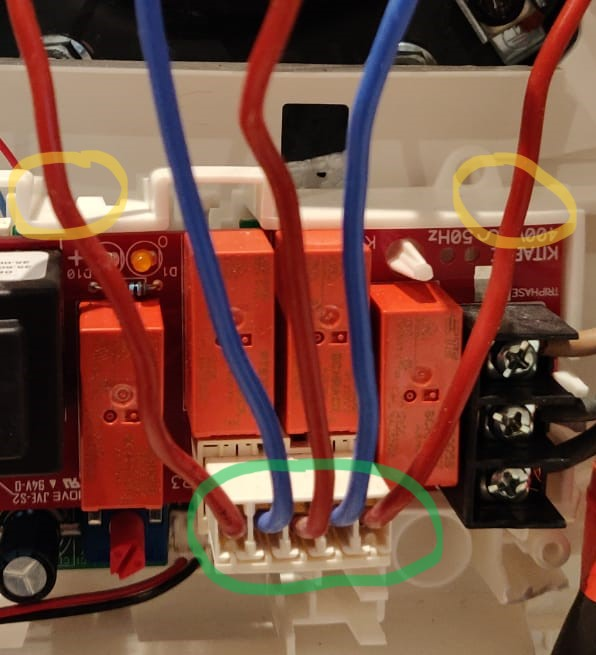
img/45df385b-920a-4481-9a2a-8a5a469650a1.jpg
