FredM67/PVRouter-3-phase/img/961b50d8-f7a0-4ff3-966e-446915d3f5a0.jpg

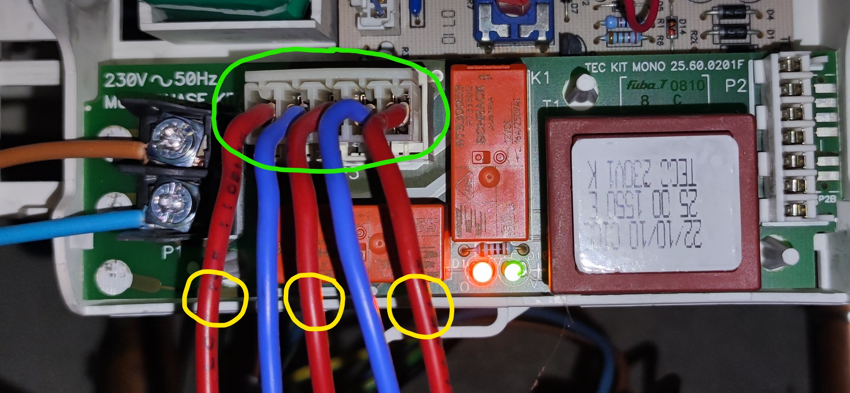
img/961b50d8-f7a0-4ff3-966e-446915d3f5a0.jpg
