FredM67/PVRouter-3-phase/img/ACI-Tri-Hybrid.jpeg

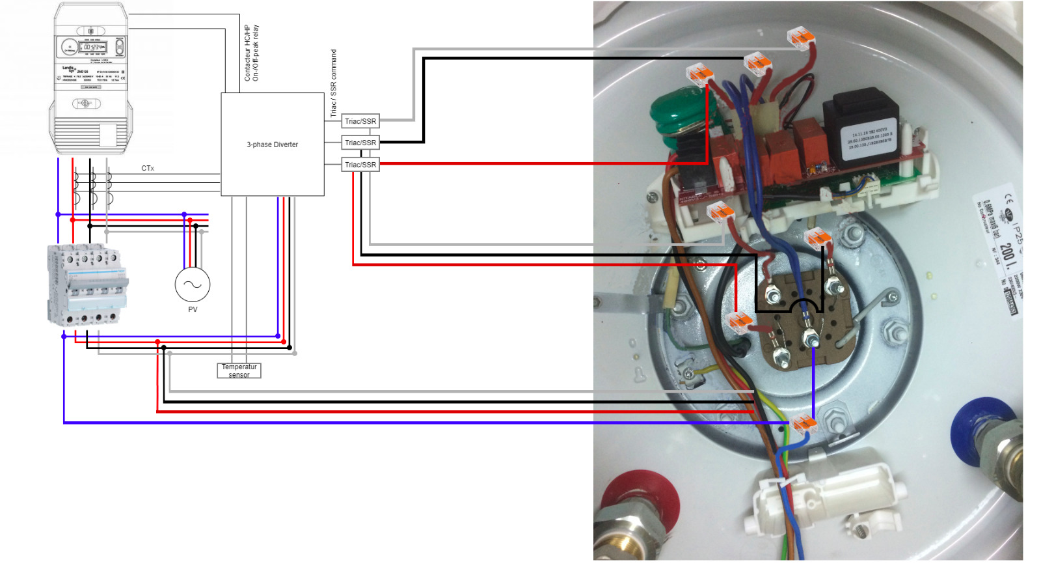
img/ACI-Tri-Hybrid.jpeg
