FredM67/PVRouter-3-phase/img/ACI-Tri.jpeg

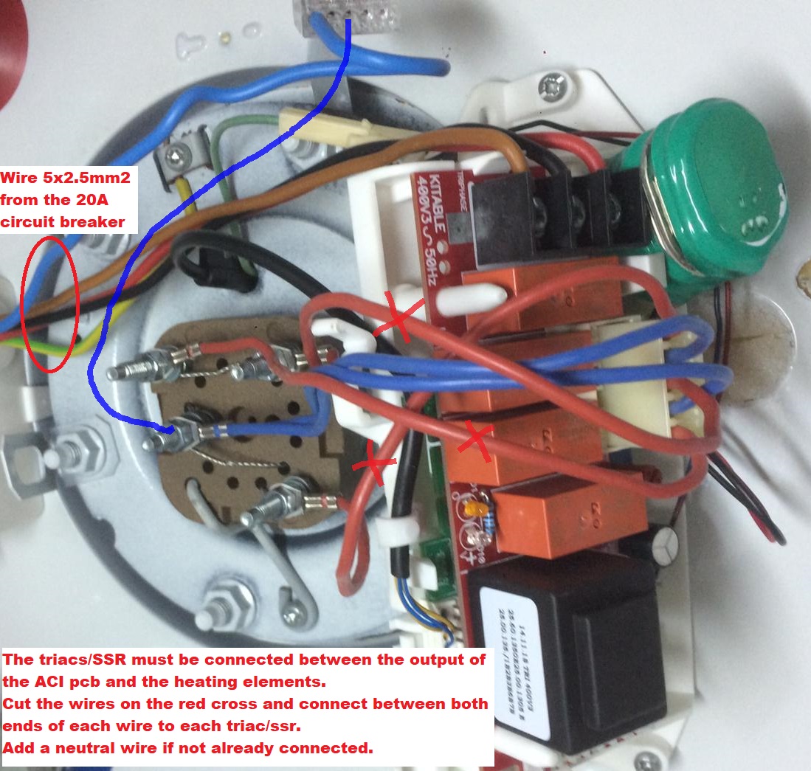
img/ACI-Tri.jpeg
