FredM67/PVRouter-3-phase/img/c3620bbc-4015-474a-bf46-3d4c9a51c02c.jpg

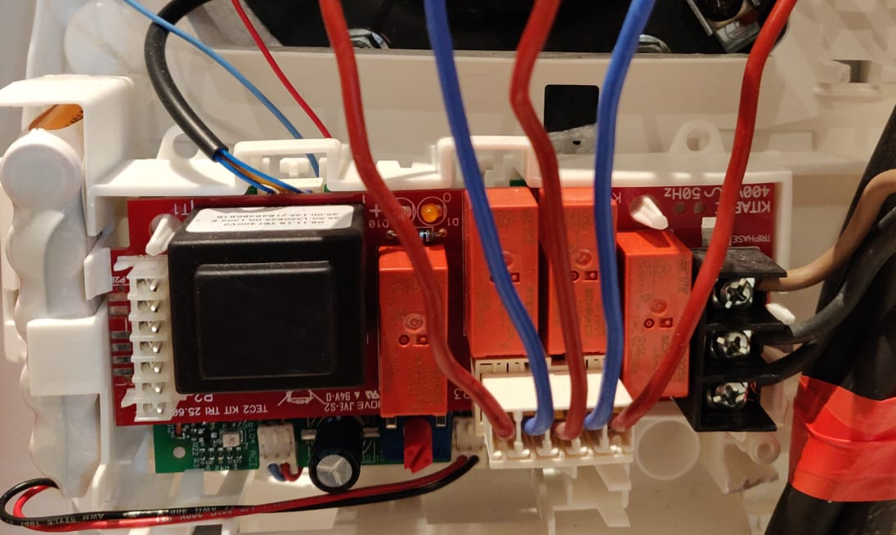
img/c3620bbc-4015-474a-bf46-3d4c9a51c02c.jpg
