FredM67/PVRouter-3-phase/img/carte-puissance-mono-non-kitable-aci.jpg

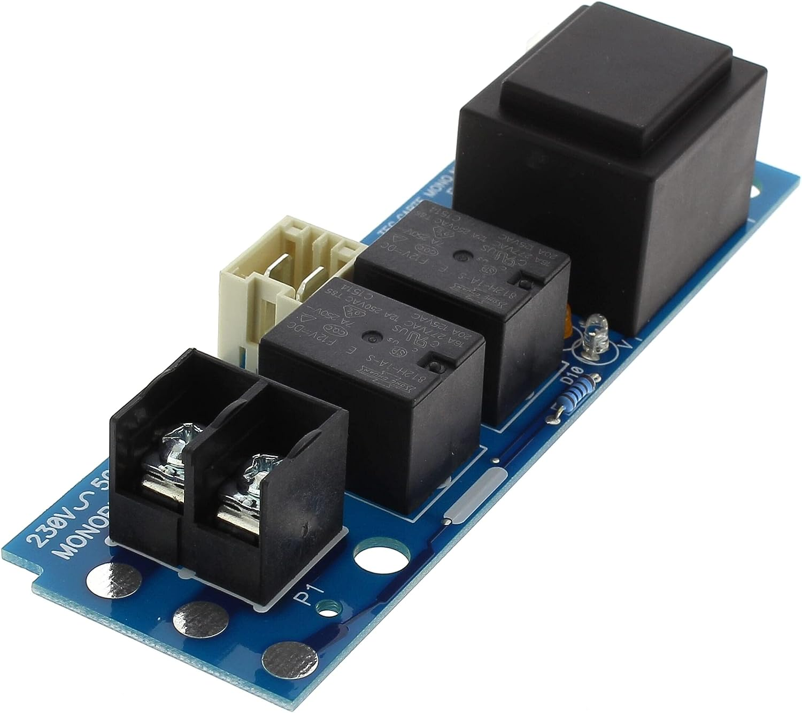
img/carte-puissance-mono-non-kitable-aci.jpg
