FredM67/PVRouter-3-phase/img/carte-puissance-mono-verte-chauffe-eau-aci.jpg

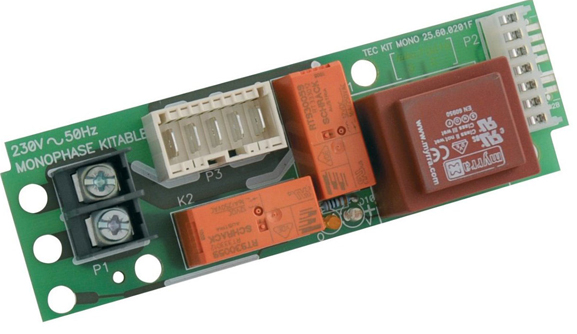
img/carte-puissance-mono-verte-chauffe-eau-aci.jpg
