FredM67/PVRouter-3-phase/img/carte-puissance-triphase-chauffe-eau-aci.jpg

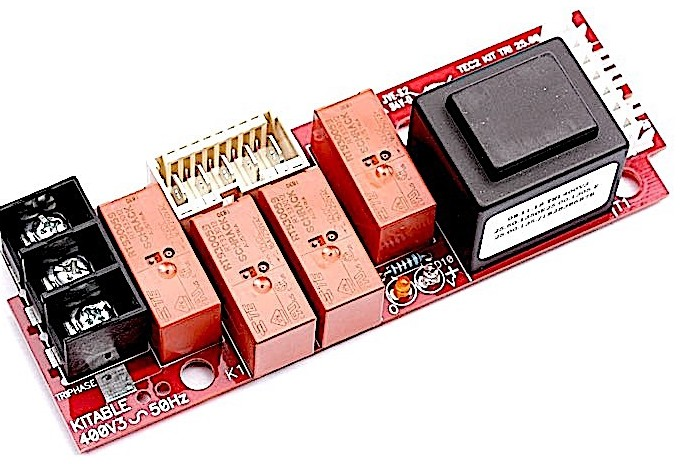
img/carte-puissance-triphase-chauffe-eau-aci.jpg
