FredM67/PVRouter-3-phase/img/schéma ACI mono.jpg

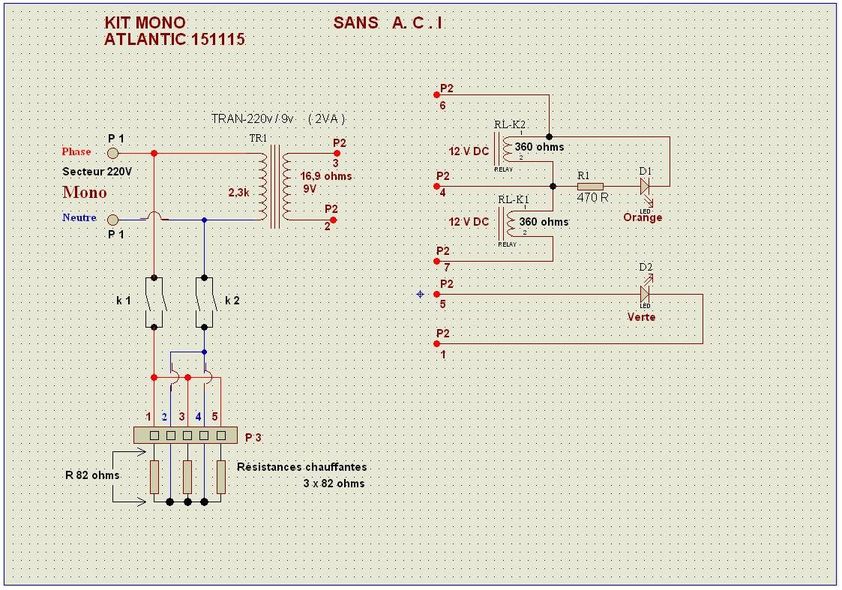
img/schéma ACI mono.jpg
