FredM67/PVRouter-3-phase/img/schéma ACI tri.jpg

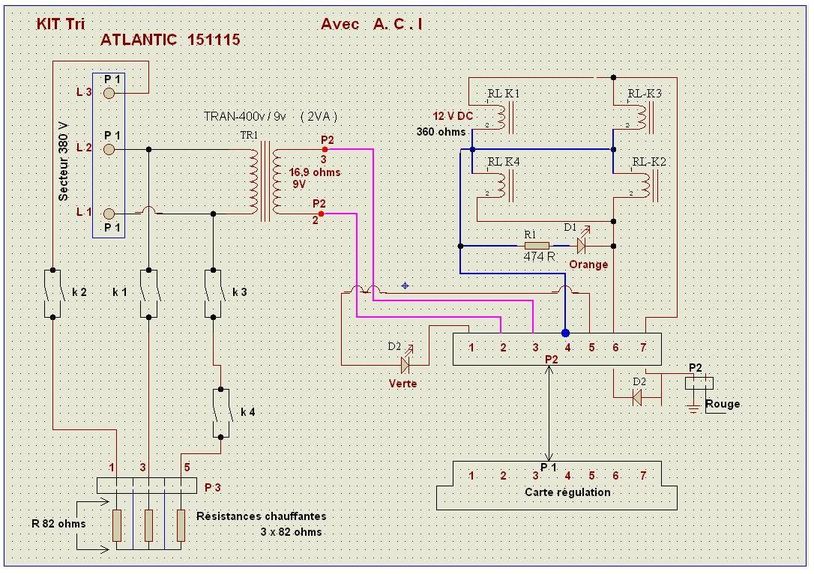
img/schéma ACI tri.jpg
