FredM67/PVRouter-3-phase/Mk2_3phase_RFdatalog_temp/docs/cloud_pattern_analysis.png

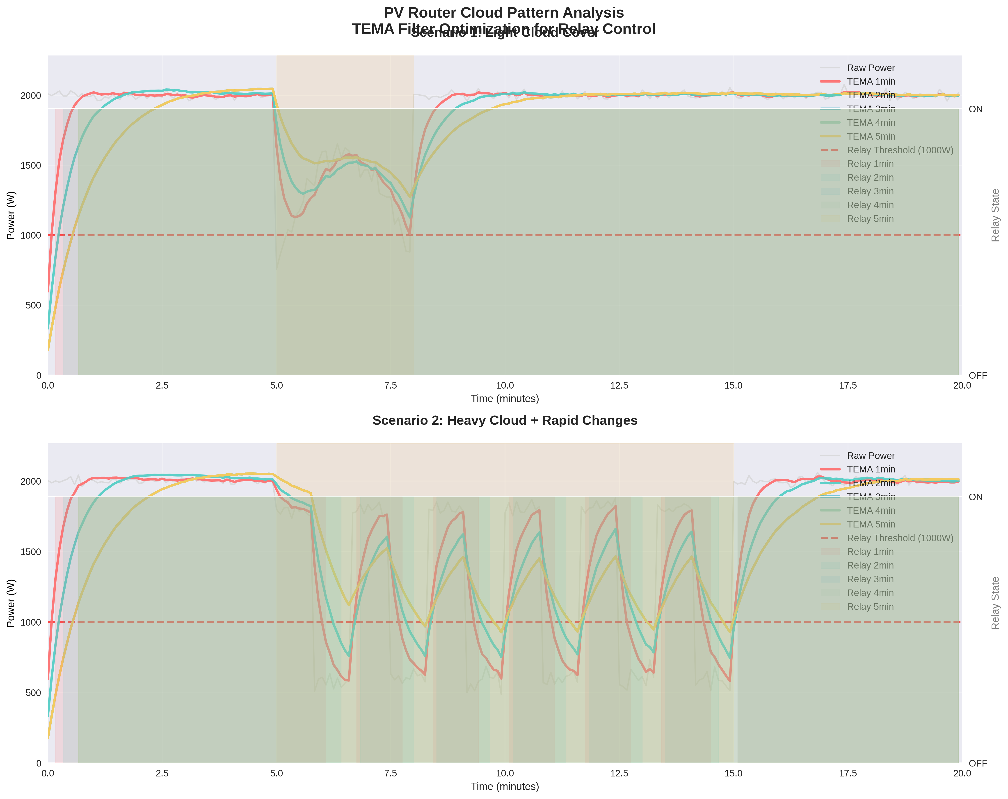
Mk2_3phase_RFdatalog_temp/docs/cloud_pattern_analysis.png
