FredM67/PVRouter-3-phase/Mk2_3phase_RFdatalog_temp/docs/relay_switching_summary.png

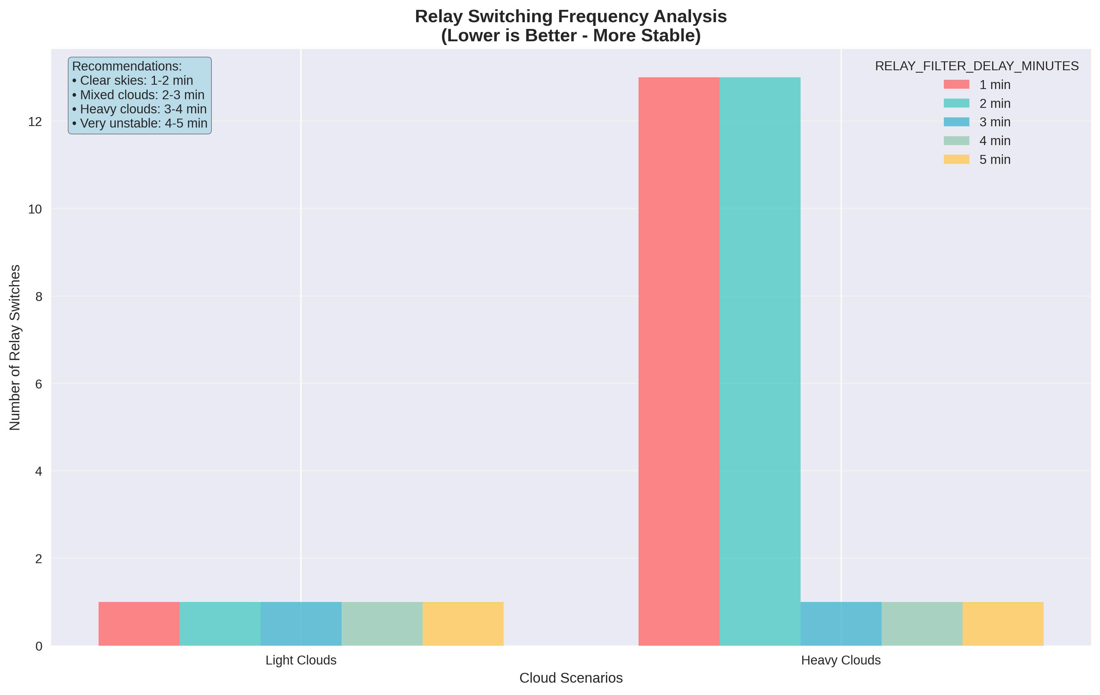
Mk2_3phase_RFdatalog_temp/docs/relay_switching_summary.png
