FredM67/PVRouter-3-phase/analysis/plots/filter_performance_analysis.png

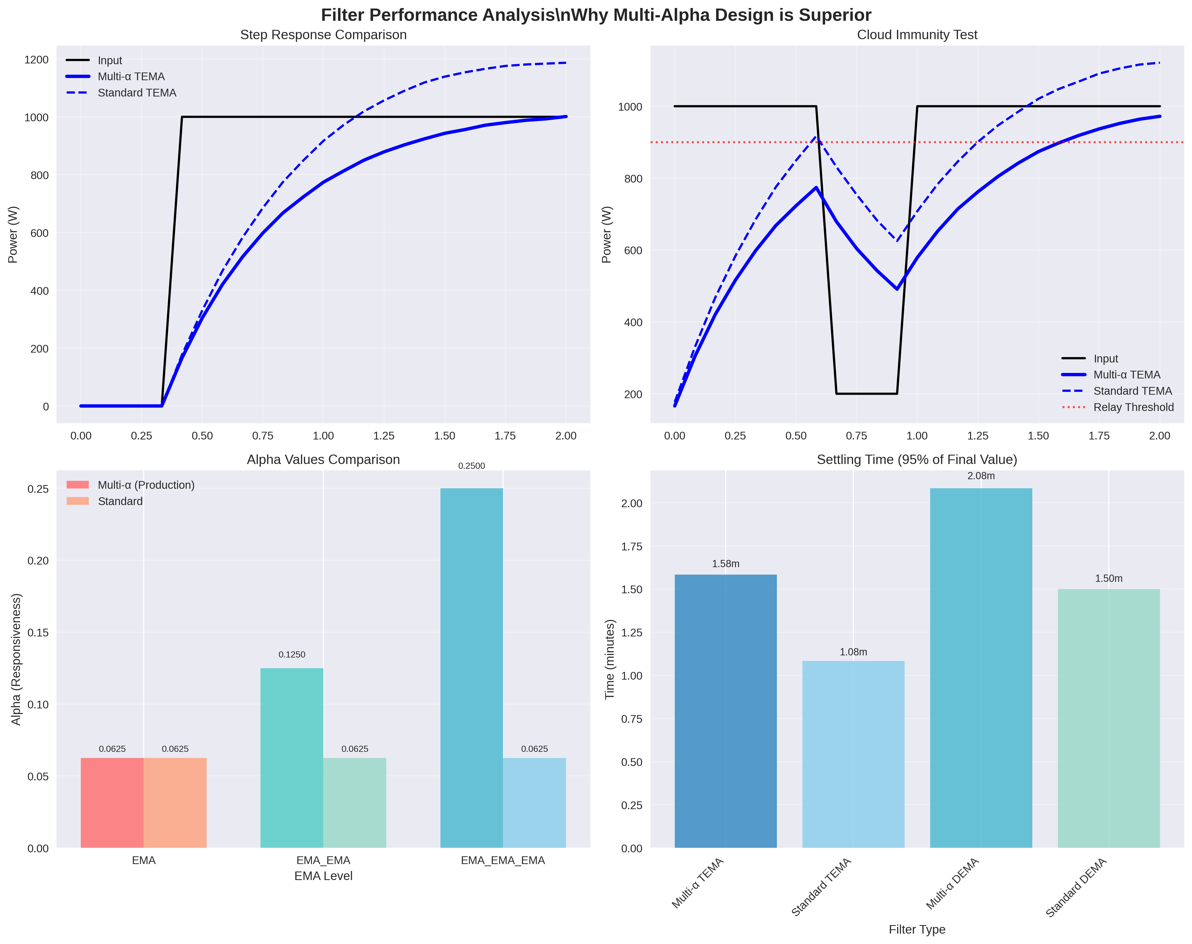
analysis/plots/filter_performance_analysis.png
