FredM67/PVRouter-3-phase/Mk2_3phase_RFdatalog_temp/HowToInstall.pdf

## Constantes de calibrage: Alimentation du routeur

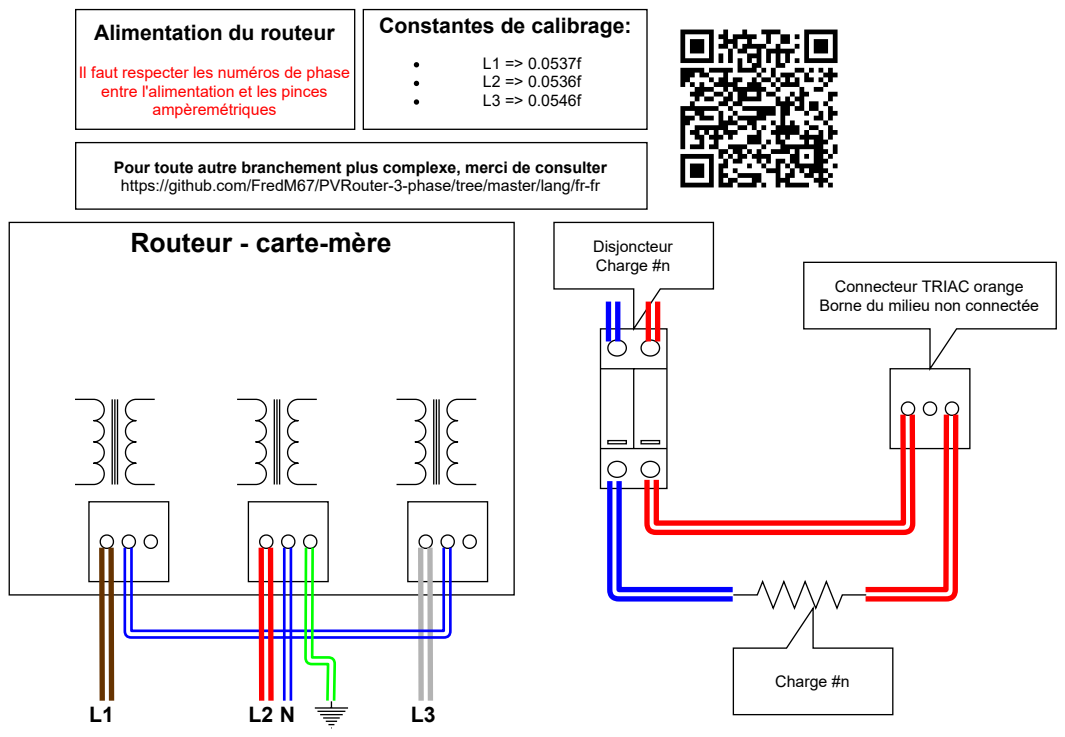
[picture p65: page 1]
Disjoncteur Charge #n; Charge #n

Il faut respecter les numéros de phase
entre l'alimentation et les pinces
ampèremétriques

Pour toute autre branchement plus complexe, merci de consulter
https://github.com/FredM67/PVRouter-3-phase/tree/master/lang/fr-fr
Routeur - carte-mère

Connecteur TRIAC orange
Borne du milieu non connectée
