FredM67/PVRouter-3-phase/docs/Legrand-Contacteur connecté.pdf

## Legrand Contacteur connecté

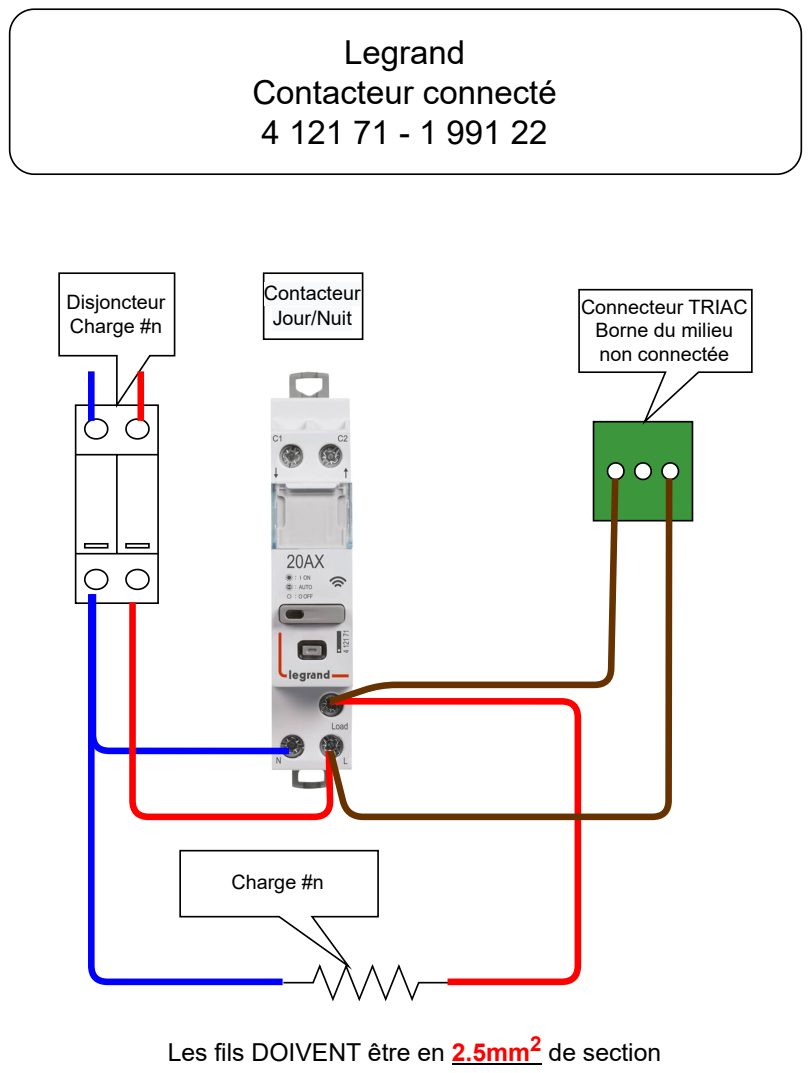
[picture p66: page 1]
de section; Disjoncteur Charge #n; Charge #n; Contacteur Jour/Nuit

Connecteur TRIAC
Borne du milieu
non connectée

Les fils DOIVENT être en 2.5mm²
