FredM67/PVRouter-3-phase/docs/Dissipateur.pdf

# Dissipateur

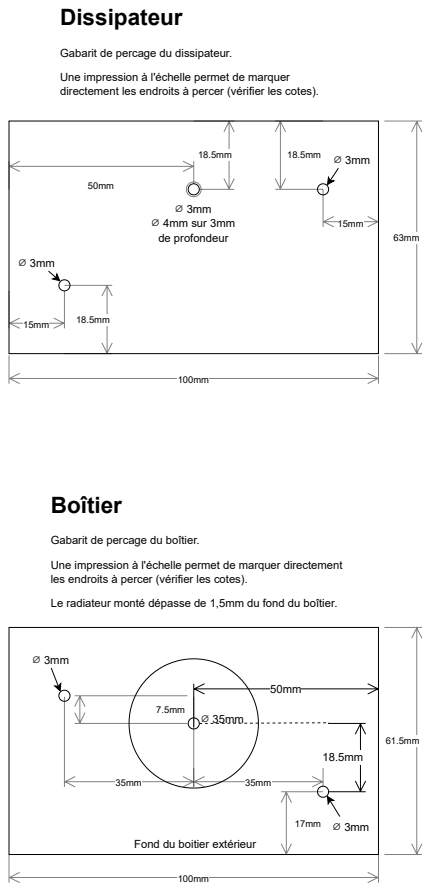
[picture p67: page 1]
⌀ 3mm ⌀ 4mm sur 3mm de profondeur; Boîtier

Gabarit de percage du dissipateur.

Une impression à l'échelle permet de marquer
directement les endroits à percer (vérifier les cotes).

Gabarit de percage du boîtier.

Une impression à l'échelle permet de marquer directement
les endroits à percer (vérifier les cotes).

Le radiateur monté dépasse de 1,5mm du fond du boîtier.

Fond du boitier extérieur
