FredM67/PVRouter-3-phase/schematics/3phase_Mainboard.pdf

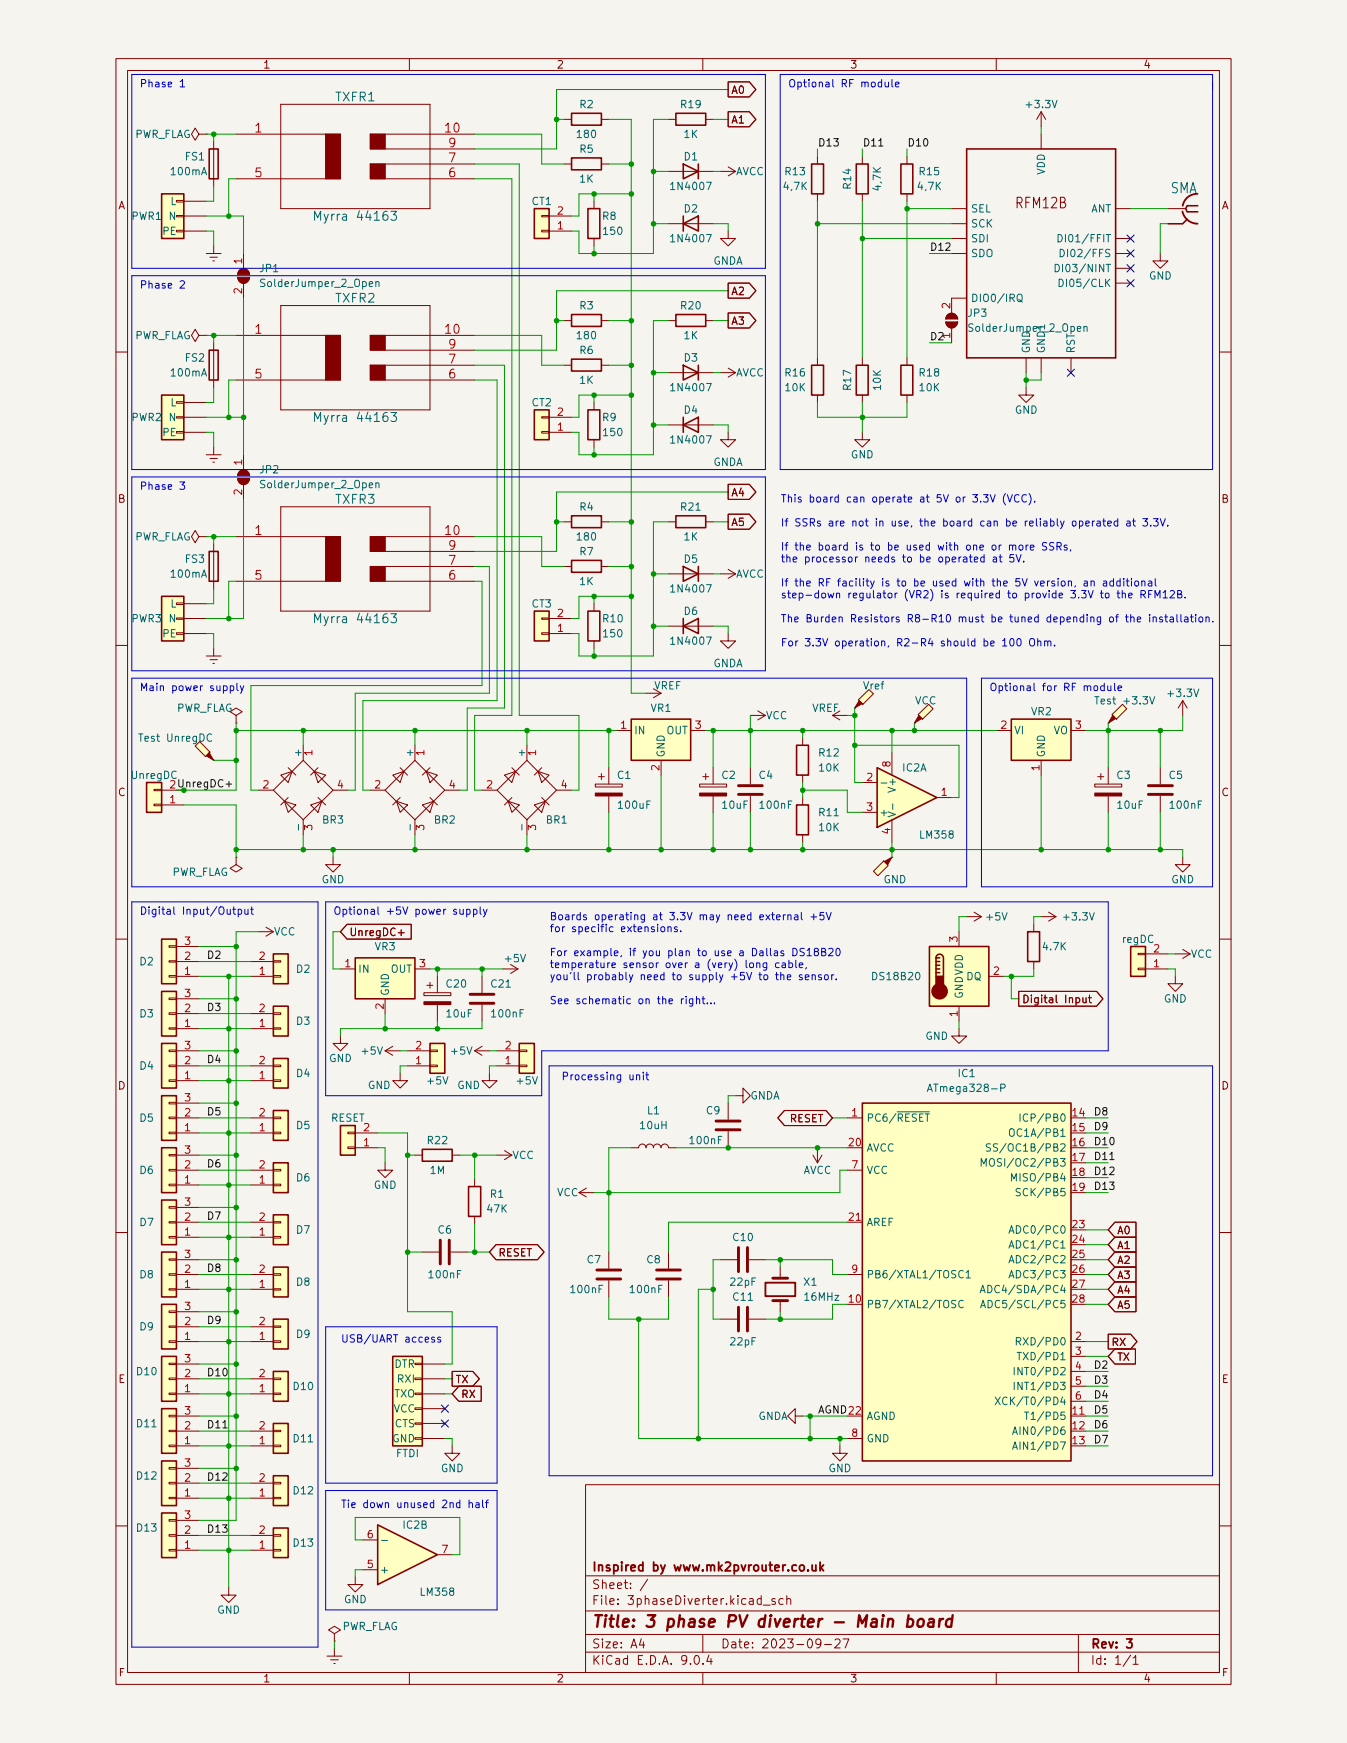
[picture p68: page 1]
