FredM67/PVRouter-3-phase/docs/Thermostat_tri_HC.pdf

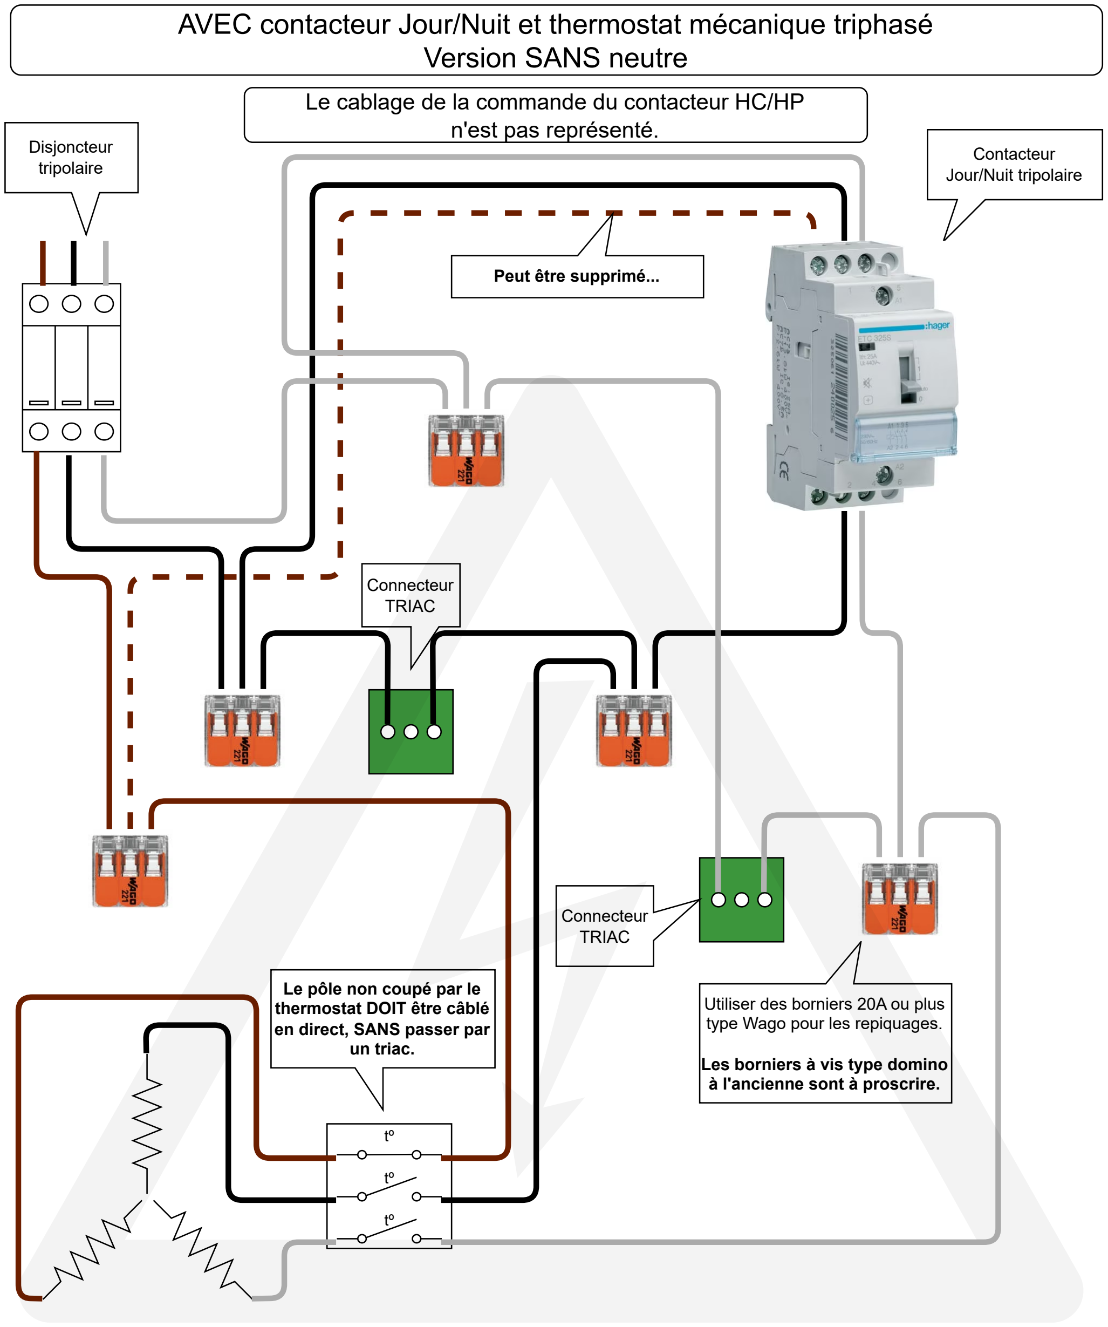
[picture p69: figure]
Version SANS neutre; Disjoncteur tripolaire; Connecteur TRIAC; Contacteur Jour/Nuit tripolaire; Utiliser des borniers 20A ou plus type Wago pour les repiquages.; Les borniers à vis type domino à l'ancienne sont à proscrire.; Le pôle non coupé par le thermostat DOIT être câblé en direct, SANS passer par un triac.; Peut être supprimé...; n'est pas représenté.

## AVEC contacteur Jour/Nuit et thermostat mécanique triphasé

### Les fils DOIVENT être en 2.5mm² de section

Il n'est pas nécessaire d'utiliser des fils de couleurs différentes, même si c'est recommandé. Il est INTERDIT d'utiliser des fils bleu (réservé au neutre) ni jaune/vert (réservé à la terre).

## Le cablage de la commande du contacteur HC/HP

## AVEC contacteur Jour/Nuit et thermostat mécanique triphasé Version AVEC neutre

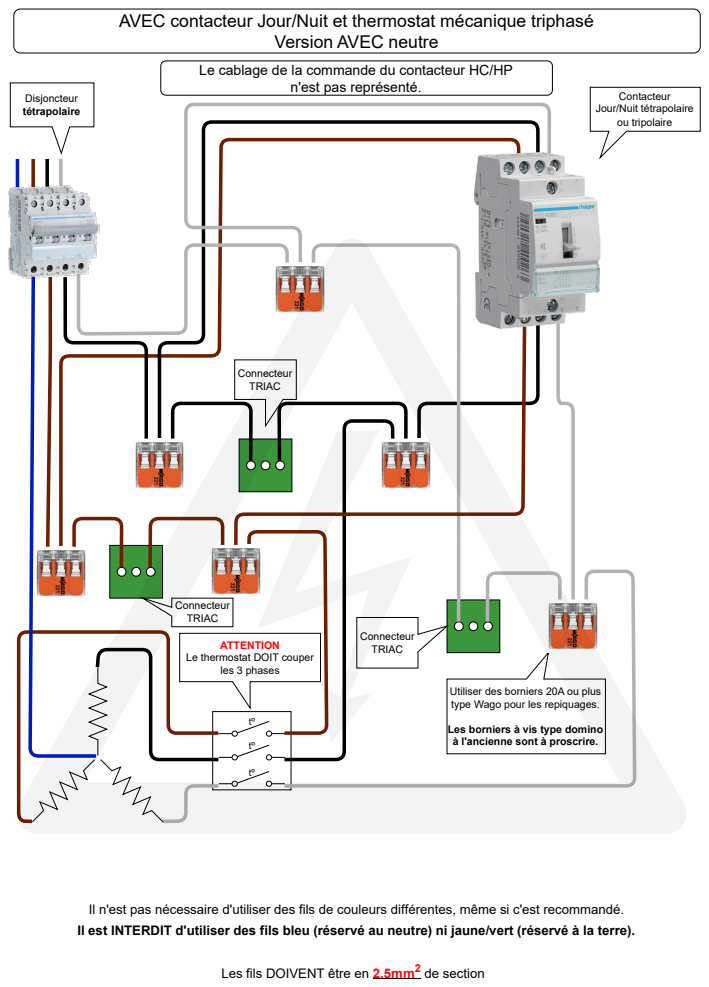
[picture p70: page 2]
Disjoncteur tétrapolaire; de section; Connecteur TRIAC

Le cablage de la commande du contacteur HC/HP

n'est pas représenté.

Contacteur
Jour/Nuit tétrapolaire
ou tripolaire

ATTENTION
Le thermostat DOIT couper
les 3 phases

Utiliser des borniers 20A ou plus
type Wago pour les repiquages.

à l'ancienne sont à proscrire. tº

Les borniers à vis type domino

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

Les fils DOIVENT être en 2.5mm²
