FredM67/PVRouter-3-phase/docs/CarteACI_Mono.pdf

## Câblage universel avec carte ACI monophasée KITABLE SANS THERMOSTAT MECANIQUE

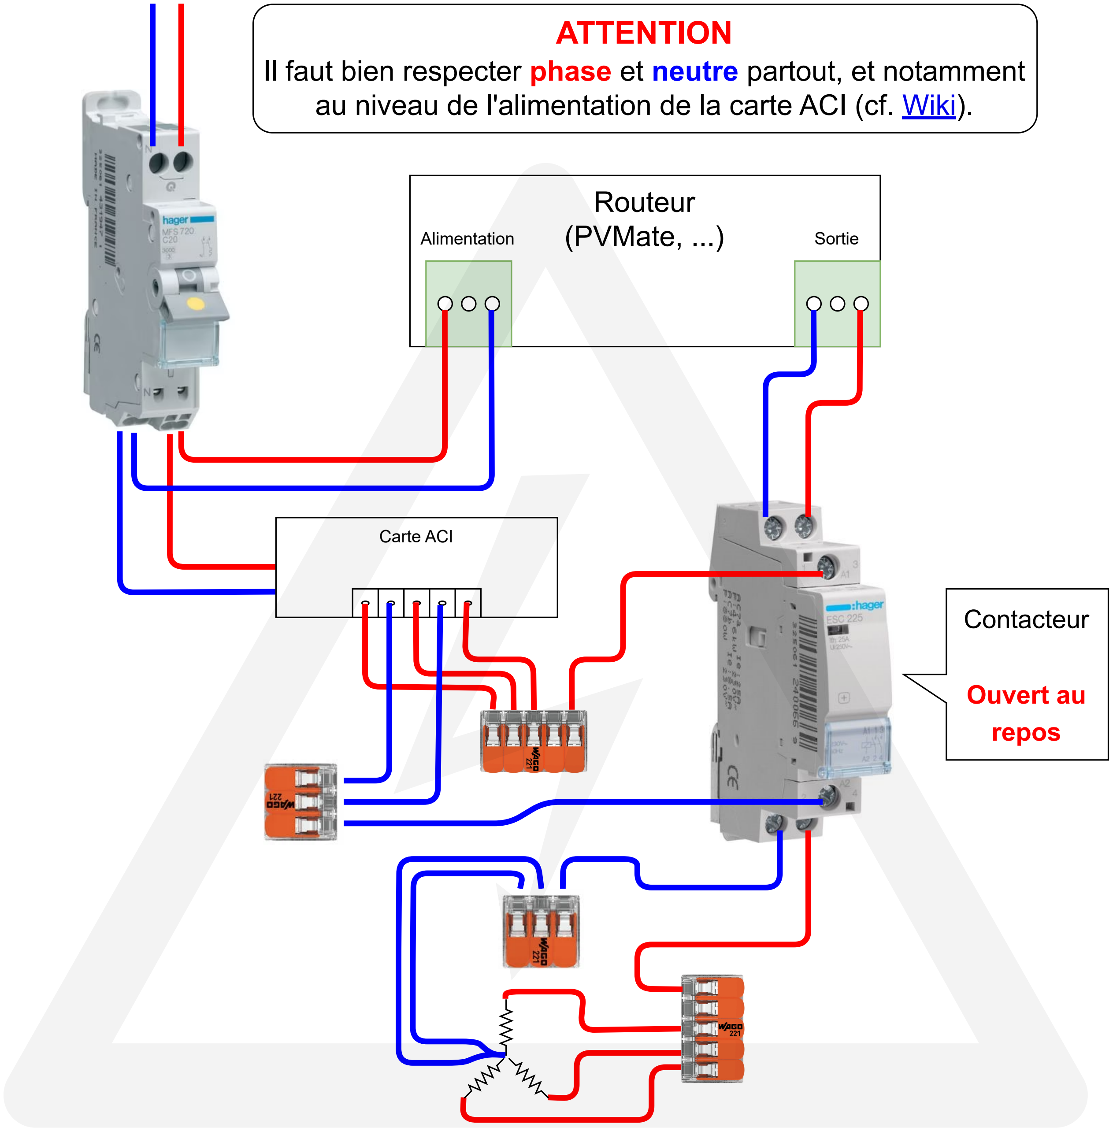
[picture p71: figure]
Carte ACI; Routeur; Alimentation; (PVMate, ...); Sortie; ATTENTION; Contacteur; Ouvert au repos

### Les fils DOIVENT être en 2.5mm² de section

Ce schéma de câblage est valable pour tous les routeurs mais est obligatoire pour les routeurs qui alimentent directement le chauffe-eau branché (par exemple eddi, Solic 200, PVMate).

Je déconseille TRÈS FORTEMENT de modifier la carte ACI comme certains le préconisent. Cela peut être dangereux, l'utilisateur perd tout recours, toute garantie, quant à un défaut de fonctionement de la carte ACI.

Pour rendre "compatible" votre chauffe-eau avec carte ACI, vous aurez besoin de :

Wago à 5 pôles (ne pas utiliser de dominos)
Wago 3 pôles
un contacteur (type jour/nuit) ouvert au repos.

Hormis les 5 cables rouges et bleus qui sortent de la carte ACI par le connecteur blanc et qui seront sectionnés, AUCUNE modification sur la carte ACI ne sera effectuée.

## Il faut bien respecter phase et neutre partout, et notamment

au niveau de l'alimentation de la carte ACI (cf. Wiki). (https://github.com/FredM67/PVRouter-3-phase/wiki/Cartes-ACI-monophas%C3%A9e-et-triphas%C3%A9e)

# ATTENTION

## Il faut bien respecter phase et neutre partout, et notamment

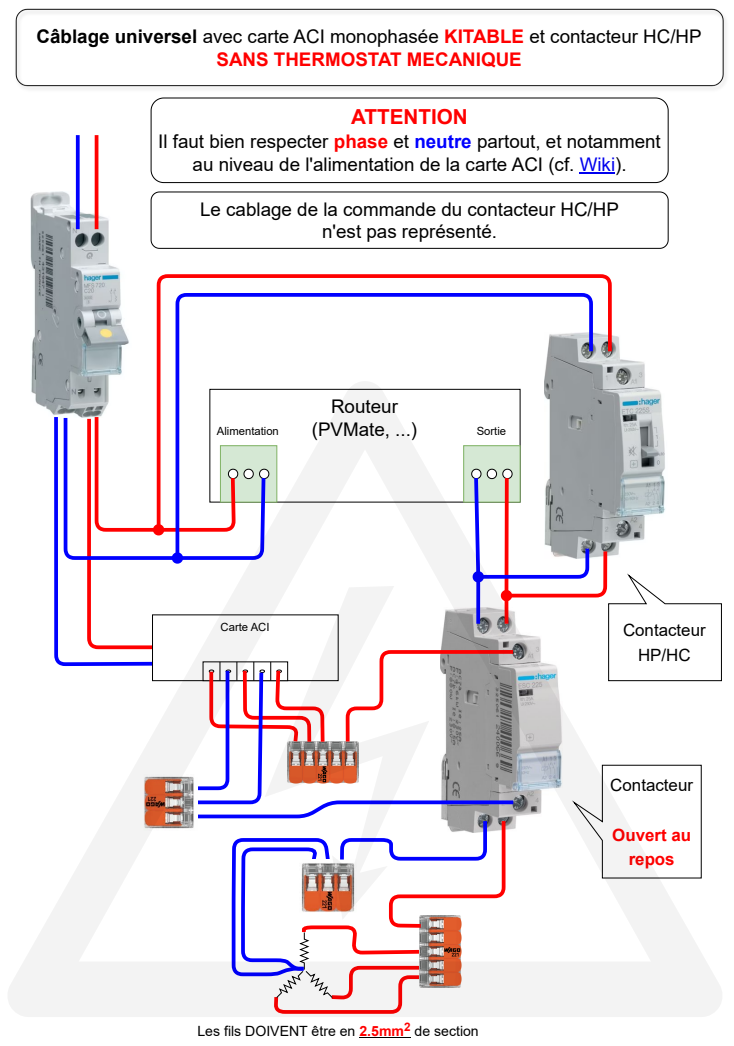
[picture p72: page 2]
Carte ACI; Routeur; Alimentation; (PVMate, ...); Sortie; Contacteur; Ouvert au repos; Contacteur HP/HC

Câblage universel avec carte ACI monophasée KITABLE et contacteur HC/HP

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

Le cablage de la commande du contacteur HC/HP

n'est pas représenté.

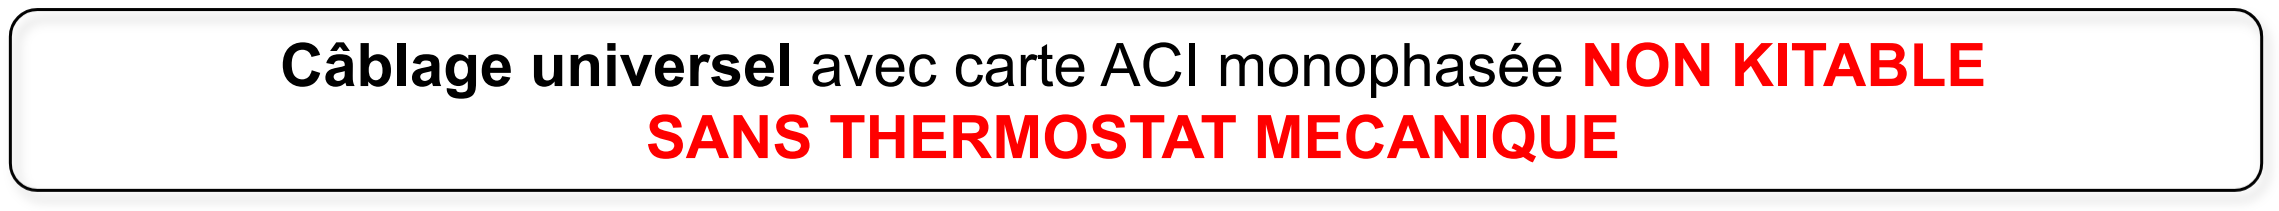
[picture p73: figure]

## Câblage universel avec carte ACI monophasée NON KITABLE

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

Pour rendre "compatible" votre chauffe-eau avec carte ACI, vous aurez besoin de :

Wago 3 pôles (ne pas utiliser de dominos)
un contacteur (type jour/nuit) ouvert au repos.

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

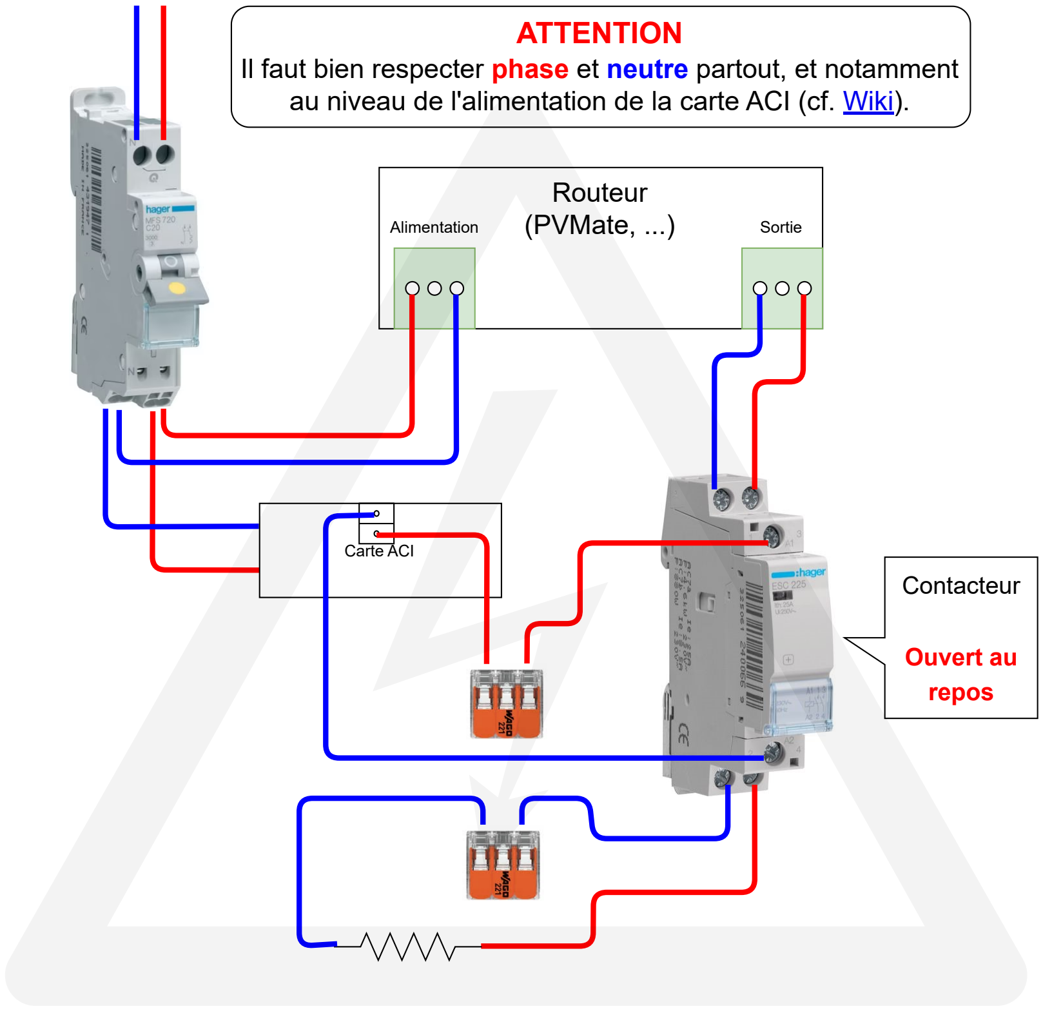
[picture p74: figure]
Routeur; Alimentation; (PVMate, ...); Sortie; ATTENTION; Contacteur; Ouvert au repos; Carte ACI

## Il faut bien respecter phase et neutre partout, et notamment

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

# ATTENTION

## Il faut bien respecter phase et neutre partout, et notamment

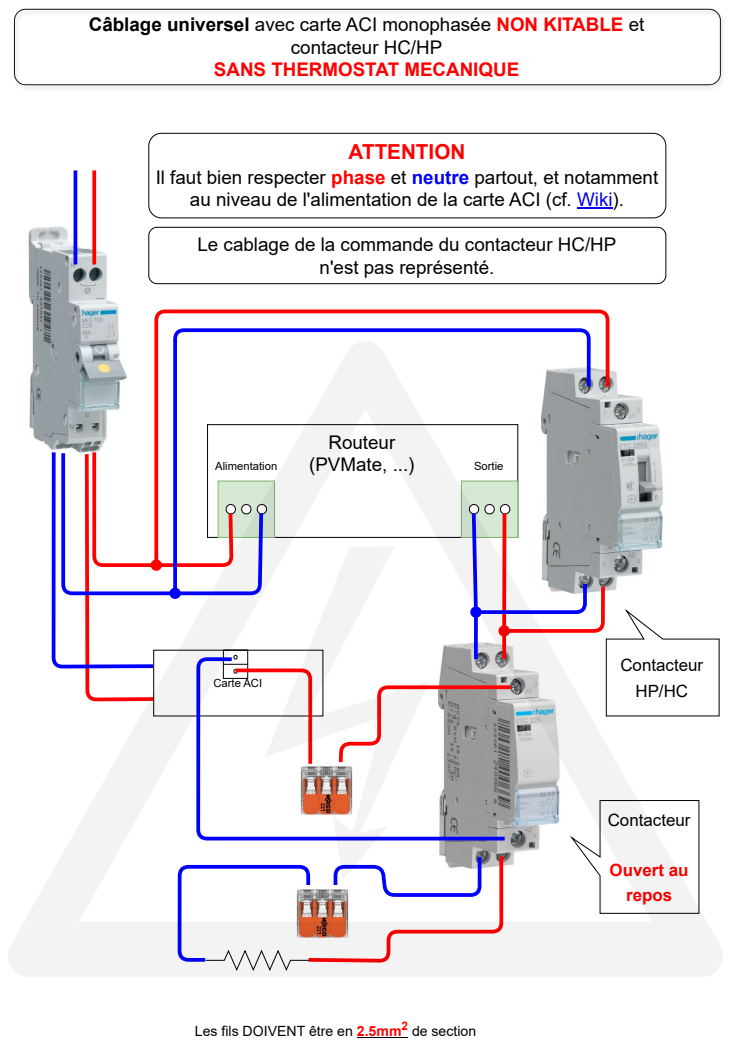
[picture p75: page 4]
Routeur; Alimentation; (PVMate, ...); Sortie; Contacteur; Ouvert au repos

Câblage universel avec carte ACI monophasée NON KITABLE et

contacteur HC/HP

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

Le cablage de la commande du contacteur HC/HP

n'est pas représenté.

HP/HC Carte ACI
