FredM67/PVRouter-3-phase/docs/Cablage Routeur.pdf

## Routeur - carte-mère

L1 | L2 | L3

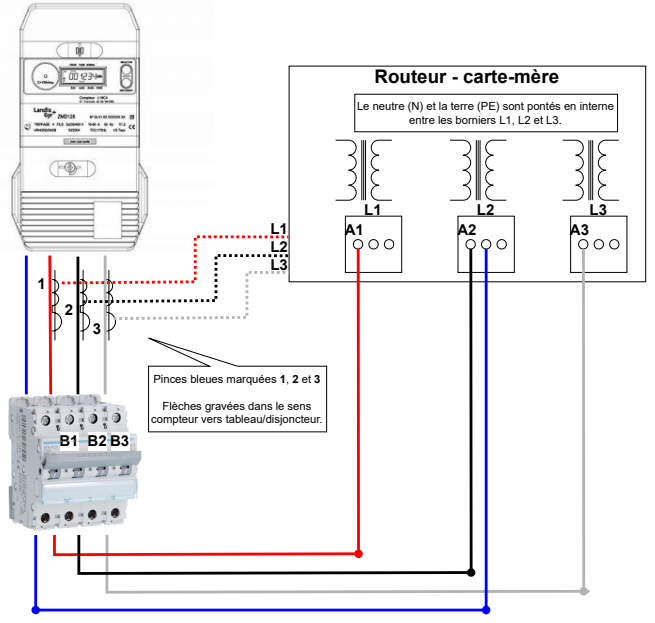
[picture p76: page 1]

Le neutre (N) et la terre (PE) sont pontés en interne

entre les borniers L1, L2 et L3.

Pinces bleues marquées 1, 2 et 3

Flèches gravées dans le sens
compteur vers tableau/disjoncteur.
