FredM67/PVRouter-3-phase/Mk2_3phase_RFdatalog_temp/version.h

#ifndef VERSION_H
#define VERSION_H

#define PROJECT_PATH "Mk2_3phase_RFdatalog_temp"
#define CURRENT_TIME "2025-10-01 13:11:14+02:00"
#define BRANCH_NAME "feature/flexible_override"
#define COMMIT_HASH "cb882bc0"

#endif  // VERSION_H
