FredM67/PVRouter-3-phase/Mk2_3phase_RFdatalog_temp/utils.h

/**
 * @file utils.h
 * @author Frédéric Metrich (frederic.metrich@live.fr)
 * @brief Some utility functions
 * @version 0.1
 * @date 2023-02-09
 *
 * @copyright Copyright (c) 2023
 *
 */

#ifndef UTILS_H
#define UTILS_H

#include <Arduino.h>
#include <ArduinoJson.h>

#include "FastDivision.h"

#include "calibration.h"
#include "constants.h"
#include "dualtariff.h"
#include "processing.h"
#include "shared_var.h"
#include "teleinfo.h"

#include "utils_rf.h"
#include "utils_temp.h"

#include "version.h"

/**
 * @brief Print the configuration during startup.
 *
 * This function outputs the system configuration to the Serial output during startup.
 * It includes details about the sketch, build information, electrical settings, and
 * enabled features.
 *
 * @details
 * - Prints the sketch ID, branch name, commit hash, and build date/time.
 * - Outputs electrical settings such as power calibration, voltage calibration, and phase calibration.
 * - Displays enabled features like temperature sensing, dual tariff, load rotation, relay diversion, and RF communication.
 * - Logs the selected datalogging format (Human-readable, IoT, or JSON).
 *
 * @ingroup Initialization
 */
inline void printConfiguration()
{
#ifndef PROJECT_PATH
#define PROJECT_PATH (__FILE__)
#endif

#ifndef BRANCH_NAME
#define BRANCH_NAME ("N/A")
#endif
#ifndef COMMIT_HASH
#define COMMIT_HASH ("N/A")
#endif

  DBUGLN();
  DBUGLN();
  DBUGLN(F("----------------------------------"));
  DBUG(F("Sketch ID: "));
  DBUGLN(F(PROJECT_PATH));

  DBUG(F("From branch '"));
  DBUG(F(BRANCH_NAME));
  DBUG(F("', commit "));
  DBUGLN(F(COMMIT_HASH));

  DBUG(F("Build on "));
#ifdef CURRENT_TIME
  DBUGLN(F(CURRENT_TIME));
#else
  DBUG(F(__DATE__));
  DBUG(F(" "));
  DBUGLN(F(__TIME__));
#endif
  DBUGLN(F("ADC mode:       free-running"));

  DBUGLN(F("Electrical settings"));
  for (uint8_t phase = 0; phase < NO_OF_PHASES; ++phase)
  {
    DBUG(F("\tf_powerCal for L"));
    DBUG(phase + 1);
    DBUG(F(" =    "));
    DBUGLN(f_powerCal[phase], 6);

    DBUG(F("\tf_voltageCal, for Vrms_L"));
    DBUG(phase + 1);
    DBUG(F(" =    "));
    DBUGLN(f_voltageCal[phase], 5);
  }

  DBUG(F("\tf_phaseCal for all phases =     "));
  DBUGLN(f_phaseCal);

  DBUG(F("\tExport rate (Watts) = "));
  DBUGLN(REQUIRED_EXPORT_IN_WATTS);

  DBUG(F("\tzero-crossing persistence (sample sets) = "));
  DBUGLN(PERSISTENCE_FOR_POLARITY_CHANGE);

  printParamsForSelectedOutputMode();

  DBUG(F("Temperature capability "));
  if constexpr (TEMP_SENSOR_PRESENT)
  {
    DBUGLN(F("is present"));
  }
  else
  {
    DBUGLN(F("is NOT present"));
  }

  DBUG(F("Dual-tariff capability "));
  if constexpr (DUAL_TARIFF)
  {
    DBUGLN(F("is present"));
    printDualTariffConfiguration();
  }
  else
  {
    DBUGLN(F("is NOT present"));
  }

  DBUG(F("Load rotation feature "));
  if constexpr (PRIORITY_ROTATION != RotationModes::OFF)
  {
    DBUGLN(F("is present"));
  }
  else
  {
    DBUGLN(F("is NOT present"));
  }

  DBUG(F("Relay diversion feature "));
  if constexpr (RELAY_DIVERSION)
  {
    DBUGLN(F("is present"));

    relays.printRelayEngineConfiguration();
  }
  else
  {
    DBUGLN(F("is NOT present"));
  }

  DBUG(F("Override feature "));
  if constexpr (OVERRIDE_PIN_PRESENT)
  {
    DBUGLN(F("is present"));

    overridePins.printOverrideConfig();
  }
  else
  {
    DBUGLN(F("is NOT present"));
  }

  DBUG(F("RF capability "));
#ifdef RF_PRESENT
  DBUG(F("IS present, Freq = "));
  if (FREQ == RF12_433MHZ)
    DBUGLN(F("433 MHz"));
  else if (FREQ == RF12_868MHZ)
    DBUGLN(F("868 MHz"));
  rf12_initialize(nodeID, FREQ, networkGroup);  // initialize RF
#else
  DBUGLN(F("is NOT present"));
#endif

  DBUG(F("Datalogging capability "));
  if constexpr (SERIAL_OUTPUT_TYPE == SerialOutputType::HumanReadable)
  {
    DBUGLN(F("in Human-readable format"));
  }
  else if constexpr (SERIAL_OUTPUT_TYPE == SerialOutputType::IoT)
  {
    DBUGLN(F("in IoT format"));
  }
  else if constexpr (SERIAL_OUTPUT_TYPE == SerialOutputType::JSON)
  {
    DBUGLN(F("in JSON format"));
  }
  else
  {
    DBUGLN(F("is NOT present"));
  }
}

/**
 * @brief Write telemetry data to Serial in JSON format.
 *
 * This function outputs telemetry data in a format compatible with JSON, including
 * power, voltage, load states, temperature, and tariff information.
 *
 * @param bOffPeak Indicates whether the system is in an off-peak tariff period.
 *
 * @details
 * - Outputs total power and phase-specific power.
 * - Includes load ON percentages for each load.
 * - Outputs temperature data if temperature sensing is enabled.
 * - Includes tariff information if dual tariff is enabled.
 *
 * @ingroup Telemetry
 */
inline void printForJSON(const bool bOffPeak)
{
  ArduinoJson::StaticJsonDocument< 256 > doc;

  // Total mean power over a data logging period
  doc["P"] = tx_data.power;

  if constexpr (RELAY_DIVERSION)
  {
    doc["R"] = relays.get_average();
  }

  if constexpr (NO_OF_PHASES == 3)
  {
    // Mean power for each phase over a data logging period
    doc["P1"] = tx_data.power_L[0];
    doc["P2"] = tx_data.power_L[1];
    doc["P3"] = tx_data.power_L[2];
  }
  else if constexpr (NO_OF_PHASES == 2)
  {
    // Mean power for each phase over a data logging period
    doc["P1"] = tx_data.power_L[0];
    doc["P2"] = tx_data.power_L[1];
  }
  else
    static_assert(NO_OF_PHASES != 1, "Unsupported number of phases");

  // Mean power for each load over a data logging period (in %)
  //for (idx = 0; idx < NO_OF_DUMPLOADS; ++idx)
  //{
  //  Serial.print(F(",L"));
  //  Serial.print(idx + 1);
  //  Serial.print(F(":"));
  //  Serial.print(copyOf_countLoadON[idx] * 100 * invDATALOG_PERIOD_IN_MAINS_CYCLES);
  //}

  if constexpr (TEMP_SENSOR_PRESENT)
  {  // Current temperature
    for (uint8_t idx = 0; idx < temperatureSensing.size(); ++idx)
    {
      if ((OUTOFRANGE_TEMPERATURE == tx_data.temperature_x100[idx])
          || (DEVICE_DISCONNECTED_RAW == tx_data.temperature_x100[idx]))
      {
        continue;
      }

      doc[String("T") + (idx + 1)] = (float)tx_data.temperature_x100[idx] * 0.01F;
    }
  }

  if constexpr (DUAL_TARIFF)
  {
    // Current tariff
    doc["TA"] = bOffPeak ? "low" : "high";
  }

  serializeJson(doc, Serial);
  Serial.println();
}

/**
 * @brief Prints data logs to the Serial output in text format.
 *
 * This function outputs telemetry data in a human-readable text format to the Serial output.
 * It includes information about power, voltage, temperature, and system performance metrics.
 *
 * @details
 * - Prints total power, phase-specific power, and RMS voltage for each phase.
 * - Includes temperature data if temperature sensing is enabled.
 * - Outputs additional system metrics like the number of sample sets and absence of diverted energy count.
 *
 * @ingroup Telemetry
 */
inline void printForSerialText()
{
  uint8_t phase{ 0 };

  Serial.print(Shared::copyOf_energyInBucket_main * invSUPPLY_FREQUENCY);
  Serial.print(F(", P:"));
  Serial.print(tx_data.power);

  if constexpr (RELAY_DIVERSION)
  {
    Serial.print(F("/"));
    Serial.print(relays.get_average());
  }

  for (phase = 0; phase < NO_OF_PHASES; ++phase)
  {
    Serial.print(F(", P"));
    Serial.print(phase + 1);
    Serial.print(F(":"));
    Serial.print(tx_data.power_L[phase]);
  }
  for (phase = 0; phase < NO_OF_PHASES; ++phase)
  {
    Serial.print(F(", V"));
    Serial.print(phase + 1);
    Serial.print(F(":"));
    Serial.print((float)tx_data.Vrms_L_x100[phase] * 0.01F);
  }

  if constexpr (TEMP_SENSOR_PRESENT)
  {
    for (uint8_t idx = 0; idx < temperatureSensing.size(); ++idx)
    {
      if ((OUTOFRANGE_TEMPERATURE == tx_data.temperature_x100[idx])
          || (DEVICE_DISCONNECTED_RAW == tx_data.temperature_x100[idx]))
      {
        continue;
      }

      Serial.print(F(", T"));
      Serial.print(idx + 1);
      Serial.print(F(":"));
      Serial.print((float)tx_data.temperature_x100[idx] * 0.01F);
    }
  }

  Serial.print(F(", (minSampleSets/MC "));
  Serial.print(Shared::copyOf_lowestNoOfSampleSetsPerMainsCycle);
  Serial.print(F(", #ofSampleSets "));
  Serial.print(Shared::copyOf_sampleSetsDuringThisDatalogPeriod);
#ifndef DUAL_TARIFF
  if constexpr (PRIORITY_ROTATION != RotationModes::OFF)
  {
    Serial.print(F(", NoED "));
    Serial.print(Shared::absenceOfDivertedEnergyCountInSeconds);
  }
#endif  // DUAL_TARIFF
  Serial.println(F(")"));
}

/**
 * @brief Sends telemetry data using the TeleInfo class.
 *
 * This function collects various telemetry data (e.g., power, voltage, temperature, etc.)
 * and sends it in a structured format using the `TeleInfo` class. The data is sent as a
 * telemetry frame, which starts with a frame initialization, includes multiple data points,
 * and ends with a frame finalization.
 *
 * The function supports conditional features such as relay diversion, temperature sensing,
 * dual tariff information, and different supply frequencies (50 Hz or 60 Hz).
 *
 * @param bOffPeak Indicates whether the system is in an off-peak tariff period.
 *
 * @details
 * - **Power Data**: Sends the total power grid data.
 * - **Relay Data**: If relay diversion is enabled (`RELAY_DIVERSION`), sends the average relay data.
 * - **Voltage Data**: Sends the voltage data for each phase.
 * - **Temperature Data**: If temperature sensing is enabled (`TEMP_SENSOR_PRESENT`), sends valid temperature readings.
 * - **Dual Tariff Data**: If dual tariff is enabled (`DUAL_TARIFF`), sends the current tariff state.
 * - **Absence of Diverted Energy Count**: The amount of seconds without diverting energy.
 *
 * @note The function uses compile-time constants (`constexpr`) to include or exclude specific features.
 *       Invalid temperature readings (e.g., `OUTOFRANGE_TEMPERATURE` or `DEVICE_DISCONNECTED_RAW`) are skipped.
 *
 * @throws static_assert If `SUPPLY_FREQUENCY` is not 50 or 60 Hz.
 */
void sendTelemetryData(const bool bOffPeak)
{
  static TeleInfo teleInfo;
  uint8_t idx{ 0 };

  teleInfo.startFrame();  // Start a new telemetry frame

  teleInfo.send("P", tx_data.power);  // Send power grid data

  if constexpr (NO_OF_PHASES > 1)
  {
    idx = NO_OF_PHASES;
    do
    {
      --idx;
      teleInfo.send("P", tx_data.power_L[idx], idx + 1);      // Send power for each phase
      teleInfo.send("V", tx_data.Vrms_L_x100[idx], idx + 1);  // Send voltage for each phase
    } while (idx);
  }

  if constexpr (RELAY_DIVERSION)
  {
    teleInfo.send("R", static_cast< int16_t >(relays.get_average()));  // Send relay average if diversion is enabled

    idx = relays.size();
    do
    {
      --idx;
      teleInfo.send("R", relays.get_relay(idx).isRelayON());  // Send state of each relay
    } while (idx);
  }

  idx = NO_OF_DUMPLOADS;
  do
  {
    --idx;
    teleInfo.send("D", Shared::copyOf_countLoadON[idx] * 100 * invDATALOG_PERIOD_IN_MAINS_CYCLES, idx + 1);  // Send load ON count for each load
  } while (idx);

  if constexpr (TEMP_SENSOR_PRESENT)
  {
    for (uint8_t idx = 0; idx < temperatureSensing.size(); ++idx)
    {
      if ((OUTOFRANGE_TEMPERATURE == tx_data.temperature_x100[idx])
          || (DEVICE_DISCONNECTED_RAW == tx_data.temperature_x100[idx]))
      {
        continue;  // Skip invalid temperature readings
      }
      teleInfo.send("T", tx_data.temperature_x100[idx], idx + 1);  // Send temperature
    }
  }

  teleInfo.send("N", static_cast< int16_t >(Shared::absenceOfDivertedEnergyCountInSeconds));  // Send absence of diverted energy count for 50Hz

  if constexpr (DUAL_TARIFF)
  {
    teleInfo.send("TA", static_cast< int16_t >(bOffPeak ? 1 : 0));  // Send current tariff state (0=high/on-peak, 1=low/off-peak)
  }

  teleInfo.send("S", Shared::copyOf_sampleSetsDuringThisDatalogPeriod);
  teleInfo.send("S_MC", Shared::copyOf_lowestNoOfSampleSetsPerMainsCycle);

  teleInfo.endFrame();  // Finalize and send the telemetry frame
}

/**
 * @brief Prints or sends telemetry data logs based on the selected output format.
 *
 * This function handles the transmission of telemetry data in various formats, such as
 * human-readable text, IoT telemetry, or JSON format. It also ensures that the first
 * incomplete datalogging event is skipped during startup.
 *
 * @param bOffPeak Indicates whether the system is in an off-peak tariff period.
 *
 * @details
 * - If RF communication is enabled, it sends RF data.
 * - Depending on the `SERIAL_OUTPUT_TYPE`, it prints data in text format, sends telemetry
 *   data, or outputs data in JSON format.
 * - Skips the first datalogging event during startup to avoid incomplete data.
 *
 * @ingroup GeneralProcessing
 */
inline void sendResults(bool bOffPeak)
{
  static bool startup{ true };

  if (startup)
  {
    startup = false;
    return;  // reject the first datalogging which is incomplete !
  }

#ifdef RF_PRESENT
  send_rf_data();  // *SEND RF DATA*
#endif

  if constexpr (SERIAL_OUTPUT_TYPE == SerialOutputType::HumanReadable)
  {
    printForSerialText();
  }
  else if constexpr (SERIAL_OUTPUT_TYPE == SerialOutputType::IoT)
  {
    sendTelemetryData(bOffPeak);
  }
  else if constexpr (SERIAL_OUTPUT_TYPE == SerialOutputType::JSON)
  {
    printForJSON(bOffPeak);
  }
}

/**
 * @brief Prints the load priorities to the Serial output.
 *
 * This function logs the current load priorities and states to the Serial output
 * for debugging purposes. It provides a detailed view of the load configuration
 * and their respective priorities.
 *
 * @details
 * - Each load's priority and state are printed in a human-readable format.
 * - This function is only active when debugging is enabled (`ENABLE_DEBUG`).
 *
 * @ingroup GeneralProcessing
 */
inline void logLoadPriorities()
{
#ifdef ENABLE_DEBUG

  DBUGLN(F("Load Priorities: "));
  for (const auto& loadPrioAndState : loadPrioritiesAndState)
  {
    DBUG(F("\tload "));
    DBUGLN(loadPrioAndState);
  }

#endif
}

/**
 * @brief Get the available RAM during setup.
 *
 * This function calculates the amount of free RAM available in the system.
 * It is useful for debugging and ensuring that the system has sufficient memory
 * for proper operation.
 *
 * @return int The amount of free RAM in bytes.
 *
 * @ingroup Debugging
 */
inline int freeRam()
{
  extern int __heap_start, *__brkval;
  int v;
  return (int)&v - (__brkval == 0 ? (int)&__heap_start : (int)__brkval);
}

#endif  // UTILS_H
