FredM67/PVRouter-3-phase/(commit log)

2019-10-28 Fix a couple of typing mistakes
2019-12-13 Update README.md
    wiring diagram added
2020-01-17 Enhancement (#2)
    * re_working... not finished
    * re-engineering...
    * Doc update
    * Update README.md
    * .
    * comments...
    * Update Mk2_3phase_RFdatalog_temp_1.ino
    fix forced load
    * Update Mk2_3phase_RFdatalog_temp_1.ino
    wrong comment fix
    * Update Mk2_3phase_RFdatalog_temp_1.ino
    * fix type
    * fix type
    * Fix signed/unsigned operations
    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
    [Mk2_3phase_RFdatalog_temp_1.ino]
2020-01-28 Minor fix Return on/off-peak
    [Mk2_3phase_RFdatalog_temp_1.ino]
2020-01-29 Tiny fix for json
    [Mk2_3phase_RFdatalog_temp_1.ino]
2020-01-31 Use of ArduinoJson for Json output
2020-03-26 Revert "New folder structure"
    This reverts commit e4305a2897afc4910fe6d61b97b36638d4efb91d.
    [Mk2_3phase_RFdatalog_temp_1.ino]
2020-04-07 Fix Load Level calc
    [Mk2_3phase_RFdatalog_temp_1.ino]
2020-04-07 Support for temperature sensor
2020-04-07 Alternate diverted energy/temperature on display
2020-05-15 More wiring diag + fixes
2020-05-21 Some fix and detailed config on start
    [Mk2_3phase_RFdatalog_temp_1.ino]
2020-05-26 Bug fix + default to NORMAL mode
    [Mk2_3phase_RFdatalog_temp_1.ino]
2020-06-02 Calibration reworked
2020-06-08 Add force switch
2020-09-06 Revert calibration values
2020-09-10 Fix force power
2020-10-28 Some fixes + pre-work for MK2PVRouterESP
    [Mk2_3phase_RFdatalog_temp_1.ino]
2020-11-04 Fix force in combination with dual tariff
    [Mk2_3phase_RFdatalog_temp_1.ino]
2020-11-04 Fix force again !
    [Mk2_3phase_RFdatalog_temp_1.ino]
2021-04-07 Fix doc link + code optimization
    [Mk2_3phase_RFdatalog_temp.ino]
2021-04-23 Squashed commit of the following:
    commit 43145c72c58a46425a4df66580dc9d2888fc254d
    Author: Frédéric Metrich <45318189+FredM67@users.noreply.github.com>
    Date: Tue Apr 20 09:18:22 2021 +0200
    Upd calib value in doc
    commit c58d577cc64e808691190ece3a105ac6c43336a6
    Author: Frédéric Metrich <45318189+FredM67@users.noreply.github.com>
    Date: Fri Apr 16 11:15:36 2021 +0200
    added fct for pin change state + upt doc
    commit 5b360ecd12ad60d34d8ea85d2ca3429137ee83f8
    Author: Fred Metrich <frederic.metrich@live.fr>
    Date: Thu Apr 15 11:37:08 2021 +0200
    Misc changes
    commit 2bd51ee38b5eb858b36813371c2de2e26c9e0044
    Author: Frédéric Metrich <45318189+FredM67@users.noreply.github.com>
    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
2021-05-15 Add schematic with off-peak contactor
2021-05-18 More details + fix schematic
2021-08-07 Revert "2 loads"
    This reverts commit a58028f42d4f11635912dbf34fa6446372afcd98.
    [Mk2_3phase_RFdatalog_temp.ino]
2021-08-13 left shit replaced with bit
    [Mk2_3phase_RFdatalog_temp.ino, cal_CTx_v_meter.ino]
2022-02-18 Update wiring diag
2022-04-07 Add schematic
2022-04-10 Upt schematic
2022-11-05 Fix voltage cal
2022-11-25 Update schematic
2023-01-16 Add high voltage watermark
2023-02-11 Gabarit de perçage
2023-03-02 Squashed commit of the following:
    commit 7acb64541202bad8c16592d1e0dde1a38d902fa0
    Date: Thu Mar 2 11:00:07 2023 +0100
    Fixes
    commit 3cece2d130989e0ab42500605f1d56fc1b5851b5
    Merge: 997f274 87399a9
    Date: Thu Mar 2 10:08:17 2023 +0100
    Merge branch 'main' into Dupuis
    commit 87399a9ac344899fd5e8432ea348936b886cbd99
    Merge: 8a95f80 b6063be
    Date: Thu Mar 2 10:07:34 2023 +0100
    Merge branch 'main' of https://github.com/FredM67/PVRouter-3-phase
    commit 8a95f808e1b3707c8b4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
    [cal_CTx_v_meter.ino, main.cpp, main.h]
2023-03-13 Refactoring (#8)
    * 1st step
    * 2nd step
    * More refactoring
    * Remove phaseCal, add lpf filter
    * Tiny refactor
    * default value
    * Fix typo
    * Partial merge from main
    * Some refactoring
    * Some refactoring
    * Add clang format file and reformat
    * More refactoring
    * Refactoring again !
    * Fix long datalogging + move rarely modified param
    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
    [Mk2_3phase_RFdatalog_temp.ino, calibration.h, config.h, constants.h, debug.h, dualtariff.h, inject_sketch_name.py]
2023-03-13 Fix default calib for voltage
    [calibration.h]
2023-06-14 Squashed commit of the following:
    commit dc1a24bbcaf0acee8d10d50eaf41c2c14b62c0ef
    Author: Frédéric Metrich <frederic.metrich@live.fr>
    Date: Wed Jun 14 20:15:49 2023 +0200
    Fix formating
    commit e3564410077e5a96d501d44319d904c885972b33
    Date: Wed Jun 14 20:13:10 2023 +0200
    Fix first dataset
    commit 9d2b4e1f6b5a34b0bfa317f35d97b6eb0aafa49f
    Date: Wed Jun 14 15:38:48 2023 +0200
    Fix
    commit 95e6994e52c52d5c7d82f03d6383b9a6e7b6b36b
    Date: Sat May 27 10:34:02 2023 +02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
    [Mk2_3phase_RFdatalog_temp.ino, config.h, config_system.h]
2023-07-01 F_relay (#13)
    * Sliding avg class added
    * Some tuning
    * get average as same type than elements
    * Add relay config class
    * Add class for relay diversion
    * Reorganize includes
    * More reorganization
    * Next step
    * More code for relay diversion
    * Set some members const
    * Set limit to duration
    * Reformating
    * Add serial output for sliding average
    * Some cleanup
    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
    [utils_relay.h]
2023-07-26 Replace div by * with compile-time inverse
    [config_system.h, dualtariff.h, main.cpp, movingAvg.h, utils.h, utils_pins.h]
2023-09-15 Squashed commit of the following:
    commit adf0ae7372e38a9aadb3e68978ecd642007b1a19
    Date: Fri Sep 15 13:56:23 2023 +0200
    Some addionnal fixes
    commit d90c334f5709233f0329ab5d08d09d5037c34cfd
    Date: Fri Sep 15 13:52:50 2023 +0200
    Some reorganizing
    commit 49de9b2d811a17cf5b39ab4fffc17bd1d92dfe8e
    Date: Sat Sep 9 11:58:39 2023 +0200
    Calib final
    commit 1acc7ca3682c03b40df4df52ebb216a4586c3422
    Date: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
    [Transformer_Checker.ino, cal_CTx_v_meter.ino, main.cpp, main.h, utils.h]
2024-01-22 Fix relay template
2024-02-12 WIP: 1772479 Fix mvAvg
    [MathPerfTests.ino, movingAvg.h]
2024-02-26 Update color in schematic
2024-03-02 Refactoring temp (#84)
    * Refactoring temp
    * Fix refactoring temperature
    [config.h, main.cpp, processing.h, utils_temp.h]
2024-03-06 Fix log when sensor disconnected
    [utils.h]
2024-03-09 Squashed commit of the following:
    commit fb99ae1cdf6c4a730b228571943398f2252a3405
    Date: Sat Mar 9 12:45:35 2024 +0100
    Add DEMA
    commit 52892c216bb24a84eb3b306bd855d5e772279857
    Date: Fri Mar 8 12:42:21 2024 +0100
    Add parenthesis
    commit 843ad1c5c39ea61edb3e4cbddbcff542a2e1559b
    Merge: f817917 8ef9f7b
    Date: Fri Mar 8 12:41:28 2024 +0100
    Merge branch 'multi-relays' of https://github.com/FredM67/PVRouter-3-phase into multi-relays
    commit f8179178ad1bb59e95896107f9c56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
2024-03-14 Doc reformulée avec la généreuse contribution de l'IA :D
2024-03-18 Fix DC offset calculation in processing.cpp
    [processing.cpp]
2024-09-05 Update installation instructions and wiring diagrams
2024-12-01 Squashed commit of the following:
    commit 0576035bad69bcb0b68354ea02de51a948aaf771
    Date: Sun Dec 1 20:29:53 2024 +0100
    Fix project error
    commit 3686e904252fdb5acb1f837132ac4c4cc4b221ba
    Date: Sat Nov 23 23:30:55 2024 +0100
    Final
    commit ab97e3e2af7ddd978b7e2d0d9671bb2a58800936
    Date: Sat Nov 23 23:18:51 2024 +0100
    Update load pin configuration and enhance data processing with low-pass filter
    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
2024-12-27 Refactor formatting and add missing includes for consistency and clarity
    [config.h, config_system.h, constants.h, utils_temp.h]
2025-01-06 Refactor ADC handling and data storage for improved clarity and performance
2025-03-11 Add static assertions for dump loads and temperature threshold validation
2025-03-28 Test ha (#92)
    * Refactor FastDivision and TeleInfo modules
    - Removed the FastDivision.h header file and implemented its functionality in FastDivision.cpp.
    - Added new FastDivision functions for efficient division operations (divu5, divu10, divu15, divu50, divu60).
    - Updated test cases for FastDivision to ensure correctness across various scenarios.
    - Introduced TeleInfo class for managing telemetry data, including methods for calculating buffer sizes and checksums.
    - Cleaned up test files by removing unnecessary includes and ensuring consistency in test structure.
    - Adjusted relay initialization tests to correct surplus threshold assertions.
    * Refactor FastDivision and TeleInfo modules for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
    [FastDivision.cpp, FastDivision.h, config.h, main.cpp, processing.cpp, processing.h, teleinfo.h, test_main.cpp]
2025-03-30 Enhance telemetry data sending by adding relay status reporting for each relay
2025-04-04 Enhance telemetry and relay documentation with detailed descriptions and updates for clarity
2025-04-04 Enhance documentation in main.cpp and processing.h for clarity and completeness; add updatePowerAndVoltageData function prototype.
2025-04-04 Refactor temperature and task handling by introducing processTemperatureData and handlePerSecondTasks functions; update function signatures for clarity.
2025-04-04 Enhance documentation for time-critical, relay diversion, temperature sensing, dual tariff, RF, and telemetry functions; add detailed descriptions and notes for clarity. Introduce processTemperatureD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
2025-04-04 Add main.h header file and declare inline functions for power and temperature processing
2025-04-05 Refactor configuration and processing code: change serial output type to IoT, remove unused optional pin initialization, and enhance pin management functions for better clarity and efficiency.
2025-04-05 Add documentation for initialization functions and classes
    - Introduced a new documentation group for Initialization.
    - Described the purpose and details of functions responsible for system setup and configuration.
    - Emphasized the importance of proper hardware component initialization for system stability.
    [Mk2_3phase_RFdatalog_temp.ino]
2025-04-05 Enhance documentation in utils.h: improve clarity and detail for printConfiguration, printForEmonCMS, printForSerialText, sendResults, logLoadPriorities, and freeRam functions.
2025-04-05 Enable nested compounds in Doxygen configuration and enhance documentation in utils_temp.h for clarity and detail on DeviceAddress structure and TemperatureSensing class methods.
2025-04-06 Fix missing newline at end of file in ewma_avg.hpp
    [ewma_avg.hpp]
2025-04-08 Fix PERSISTENCE_FOR_POLARITY_CHANGE value to 1 for correct polarity confirmation
    [processing.h]
2025-04-10 Implement fast division functions and update configuration for temperature sensing
2025-04-10 Add ArduinoJson library to CodeQL workflow for enhanced JSON handling
2025-04-11 Refactor versioning system: implement git revision and branch retrieval, update version.h generation, and add ISR for ADC conversion
2025-04-12 Fix load addition/removal condition to check for exact match with NO_OF_DUMPLOADS
    [processing.cpp]
2025-04-13 Initialize arrays to prevent undefined behavior and improve clarity
    [processing.cpp]
2025-04-15 Refactor division macros to constexpr functions, update unused pin definitions, and improve pin validation checks for clarity and consistency
2025-04-15 Refactor pin manipulation functions to remove redundant 'const' qualifiers and improve consistency; update static_assert for EMONESP_CONTROL configuration check
2025-04-18 Remove unnecessary Arduino.h include from ewma_avg.hpp to improve clarity and reduce dependencies
2025-05-09 Refactor serial initialization and improve pin state retrieval; update documentation and binary files
2025-05-21 Update README and config files for ESP32 expansion board integration; add detailed configuration instructions and clarify pin usage for Home Assistant control.
2025-05-21 Update README to enhance ESP32 integration instructions; clarify Home Assistant control features and add detailed setup guide.
2025-05-22 Add configuration instructions for integration without expansion board in README
2025-05-22 Fix formatting and clarify GPIO usage for temperature sensors in Home Assistant integration section of README
2025-06-23 Update pin state handling in proceedLoadPrioritiesAndOverridingDualTariff function
2025-07-17 Add warning for ArduinoJson library version requirement in README
2025-07-17 Update README formatting and clarify ArduinoJson library version requirement
2025-08-14 Fix formatting in size template declarations and update version header comment style
    [types.h, version.h]
2025-08-24 Fix schematic pdf
2025-09-05 Initial commit of remoteUnit_fasterControl_1.ino sketch for controlling a remote load with RF link. Includes features for energy measurement, RF link status indication, and a 4-digit display. Updated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
2025-09-06 Add comprehensive architecture and performance documentation for PVRouter
    - Created README.md to provide an overview of the software architecture, key performance metrics, and safety features.
    - Developed architecture.md detailing the software structure, module responsibilities, data flow, and memory architecture.
    - Added performance.md with in-depth analysis of timing measurements, memory usage, optimization strategies, and scalability analysis.
2025-09-06 docs: Add comprehensive technical documentation
    - Add memory-layout.md: RAM/Flash analysis and optimization strategies
    - Add interrupts.md: ADC processing and ISR design details
    - Add power-calculation.md: Mathematical foundations and algorithms
    - Add configuration.md: Compile-time validation and type safety
    - Add contributing.md: Development guidelines and safety requirements
    - Add testing.md: Testing methodologies and procedures
    - Add debugging.md: Troubleshooting and diagnostic techniques
    All documentation includes practical examples, safety considerations,
    performance analysis, and best practices for power electronics applications.
    Resolves broken documentation links in docs/README.md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
    [version.h]
2025-09-06 docs: Update interrupt system, memory layout, and performance documentation for SAMD21 migration and Rust implementation
2025-09-07 Feature/relay config improvements and battery docs (#111)
    * Major improvements: Relay configuration, EWMA enhancements, and battery system documentation
    This commit includes several major improvements and new features:
    ## Relay Configuration Improvements
    - Implement C++17 CTAD and deduction guides for automatic relay count deduction
    - Add MINUTES() macro for cleaner delay configuration syntax
    - Remove magic numbers in favor of RELAY_FILTER_DELAY configuration variable
    - Enable direct RelayEngine construction without helper functions
    - Improve code maintainability and user experience
    ## EWMA Filter Enhancements
    - Add comprehensive EWMA tuning analysis and benchmarking tools
    - Implement TEM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
2025-10-02 Feature/flexible override (#114)
    * config: Update OVERRIDE_PIN_PRESENT and forcePin values for improved functionality
    * feat: Add utils_override.h for handling override pin configurations and update config.h
    * refactor: Replace get_size() with size() for consistency across utility classes
    OverridePins code documentation
    * refactor: Remove unused temperature sensor addresses for cleaner configuration
    * feat: Update relay diversion configuration and add compile-time utility functions for load and relay pin retrieval
    * refactor: Clean up spacing in RELAY_DIVERSION definition for consistency
    * chore: Update CLANG_FORMAT_VERSION to 18.1.3 for code formatting consistency
    * chore: Revert CLA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
    [Mk2_3phase_RFdatalog_temp.ino, config.h]
2025-10-02 bugfix: add support for instant power telemetry (#116)
    * feat: add support for instant power telemetry
    * fix: update comment for relay state in telemetry data function
    * feat: add comprehensive TeleInfo unit tests for functionality and edge cases
    * style: format code for consistency in test_main.cpp
    [teleinfo.h, test_main.cpp, utils.h]
2025-10-25 bugfix: return early when no dumploads; use explicit cast for index in updatePhysicalLoadStates
    - Add constexpr early return if NO_OF_DUMPLOADS == 0 to avoid running rotation logic when no loads are configured.
    - Use static_cast<uint8_t>(NO_OF_DUMPLOADS - 1) for the loop index to make the type explicit and avoid potential narrowing/implicit conversion issues.
    [processing.cpp]
2026-05-11 docs: add visual diagrams for relay threshold and timing configuration
    Add ASCII diagrams to the relay configuration section in both EN and FR
    READMEs illustrating the power-axis threshold zones, minON/minOFF timer
    timeline, and multi-relay try-in-order logic (skip if not eligible, stop
    on first successful state change).
