FredM67/PVRouter-3-phase/img/66680b82-261f-409e-a767-3690944cae35.jpg

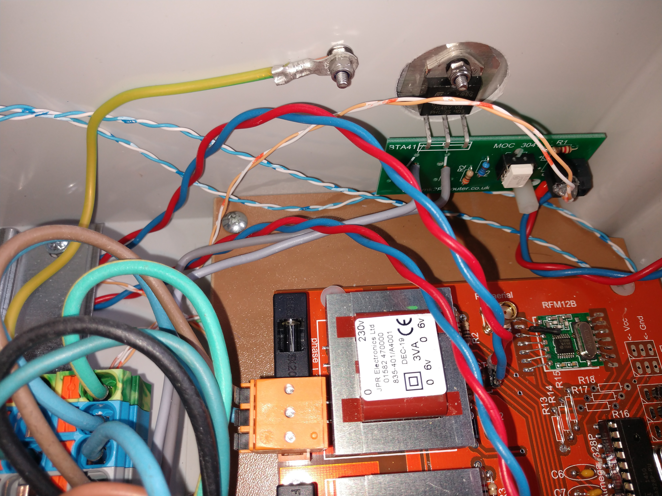
[picture p13: img/66680b82-261f-409e-a767-3690944cae35.jpg]
img/66680b82-261f-409e-a767-3690944cae35.jpg
